brenulevi/GravitumFCS/Hardware/Airplane.pdf

# Gravitum Flight Control - Hardware Components

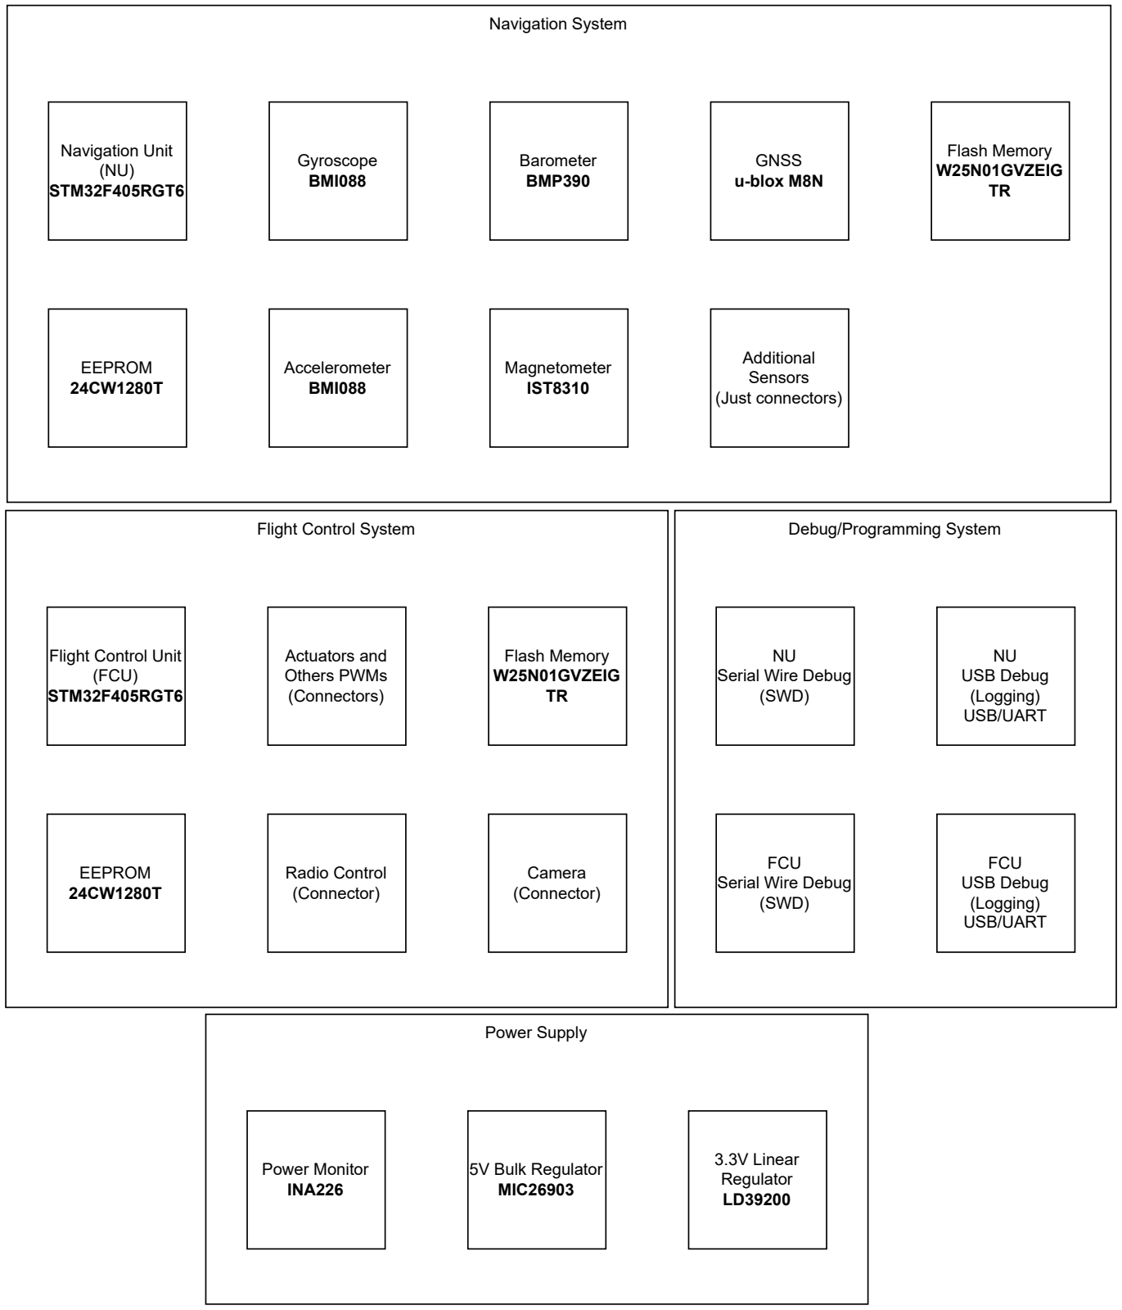
[picture p1: figure]
Power Supply; Power Monitor INA226; 5V Bulk Regulator MIC26903; 3.3V Linear Regulator LD39200; Navigation System; Navigation Unit (NU) STM32F405RGT6; EEPROM 24CW1280T; Gyroscope BMI088; Accelerometer BMI088; Barometer BMP390; Magnetometer IST8310; GNSS u-blox M8N; Additional Sensors (Just connectors); Flash Memory W25N01GVZEIG TR; Flight Control System; Flight Control Unit (FCU) STM32F405RGT6; Actuators and Others PWMs (Connectors); Radio Control (Connector); Camera (Connector); Debug/Programming System; NU Serial Wire Debug (SWD); NU USB Debug (Logging) USB/UART; FCU Serial Wire Debug (SWD); FCU USB Debug (Logging) USB/UART

# Gravitum Flight Control - Protocols

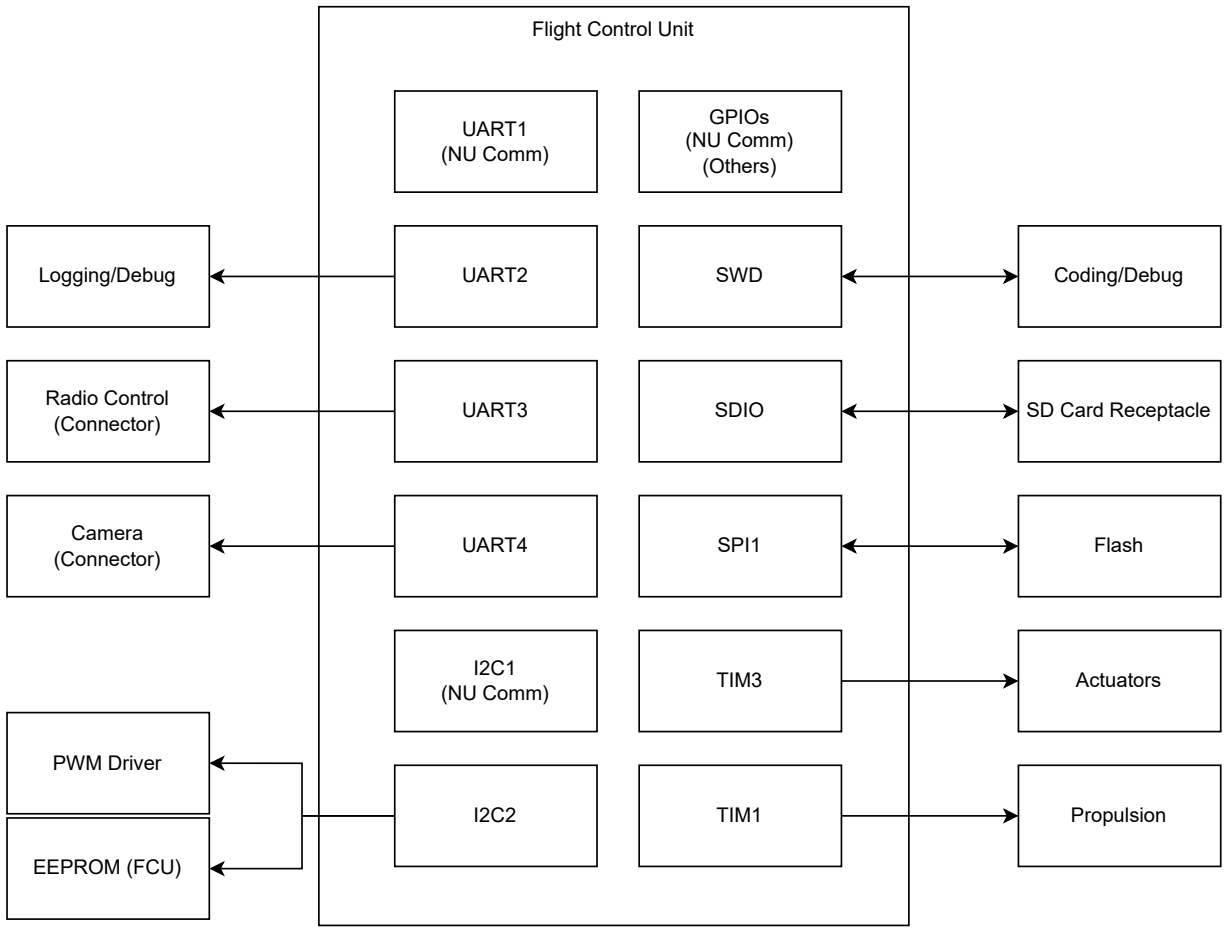
[picture p2: figure]
Flight Control Unit; UART1 (NU Comm); UART2; UART3; UART4; I2C1 (NU Comm); TIM1; TIM3; SPI1; SDIO; SWD; GPIOs (NU Comm) (Others); Logging/Debug; Radio Control (Connector); Camera (Connector); PWM Driver; EEPROM (FCU); Actuators; Propulsion; Flash; SD Card Receptacle; Coding/Debug

# Gravitum Flight Control - Protocols

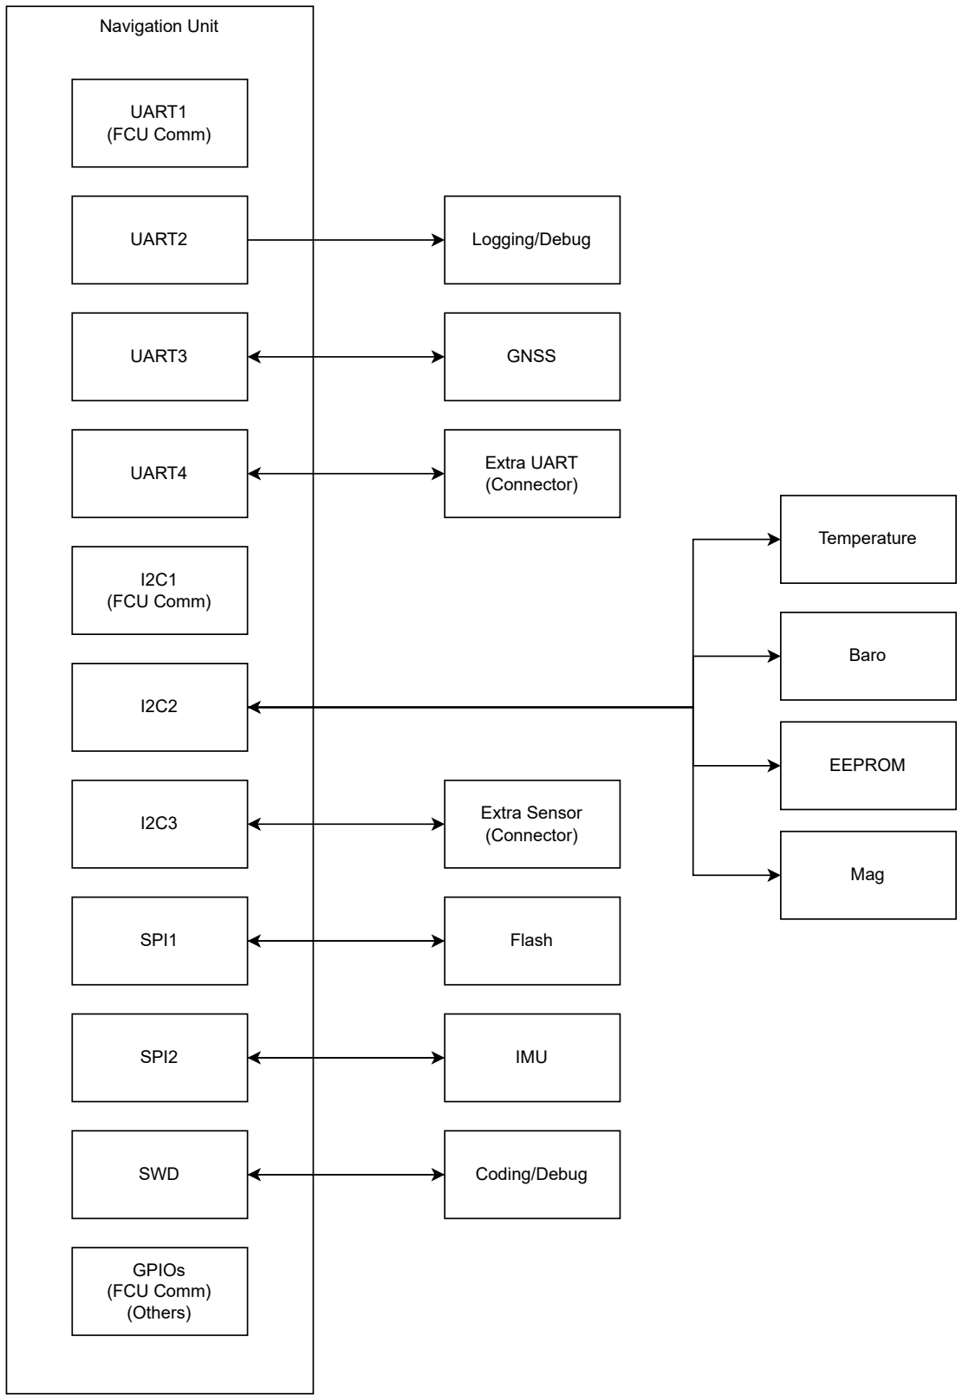
[picture p3: figure]
Navigation Unit; UART1 (FCU Comm); GPIOs (FCU Comm) (Others); UART2; UART3; UART4; I2C1 (FCU Comm); SPI1; SPI2; SWD; Logging/Debug; GNSS; Extra UART (Connector); Temperature; Baro; EEPROM; Mag; Extra Sensor (Connector); Flash; IMU; Coding/Debug
