brenulevi/GravitumFCS/documentation/flight_control_unit_pin_assignment.png

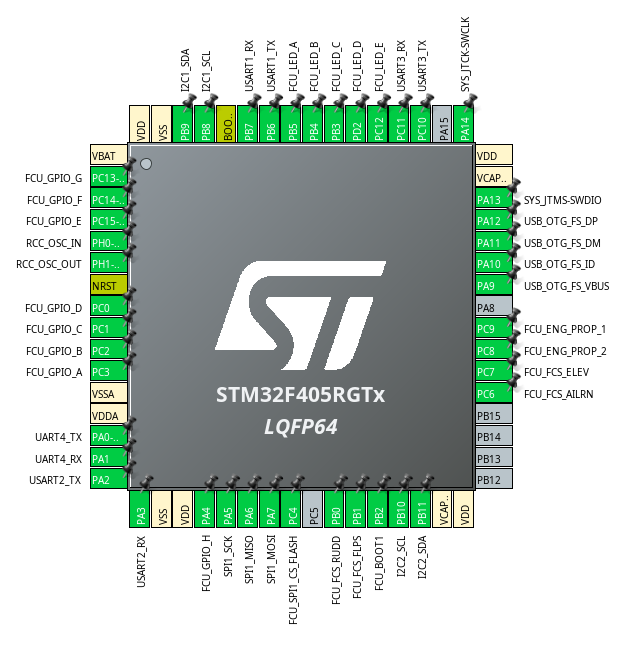
documentation/flight_control_unit_pin_assignment.png
