brenulevi/GravitumFCS/documentation/navigation_unit_pin_assignment.png

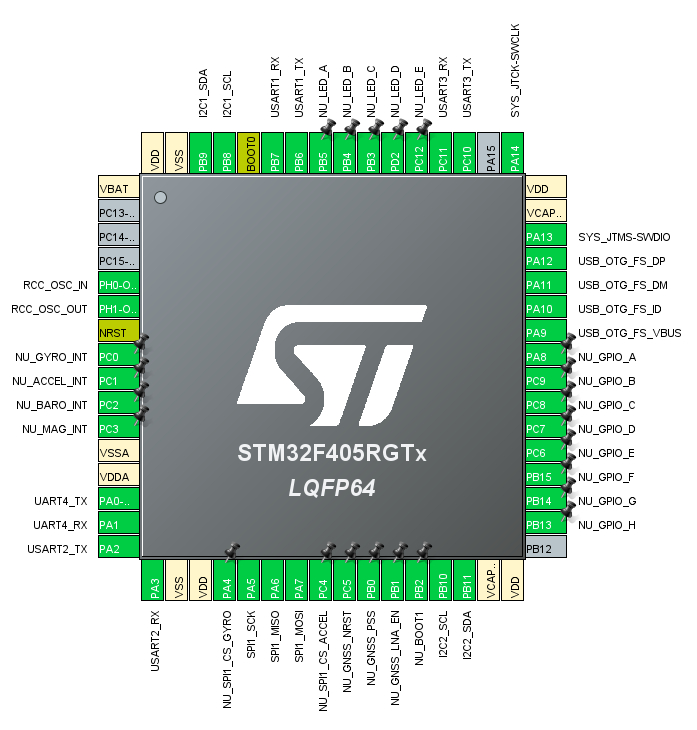
documentation/navigation_unit_pin_assignment.png
