brenulevi/GravitumFCS/hardware/3d_models/SM04B-GHS-TB_LF__SN_-.step

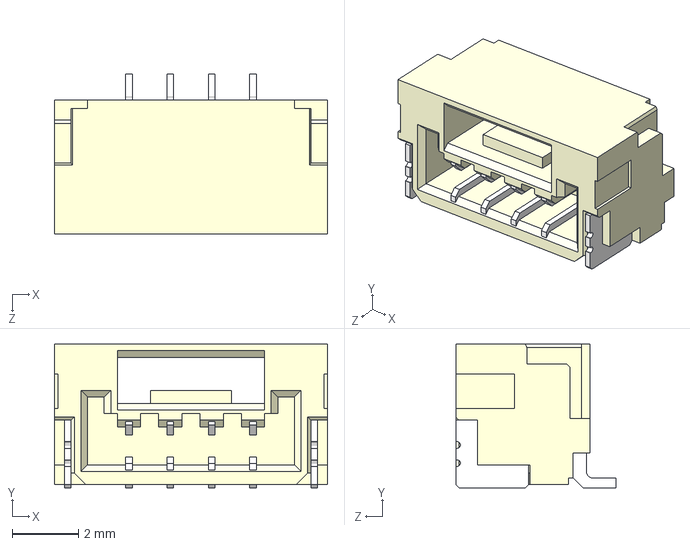
[picture p6: CAD file, 2026-02-11]
hardware/3d_models/SM04B-GHS-TB_LF__SN_-.step
8.25 x 4.35 x 4.85 mm
