brenulevi/GravitumFCS/hardware/3d_models/MPRLS0025PA00001A.step

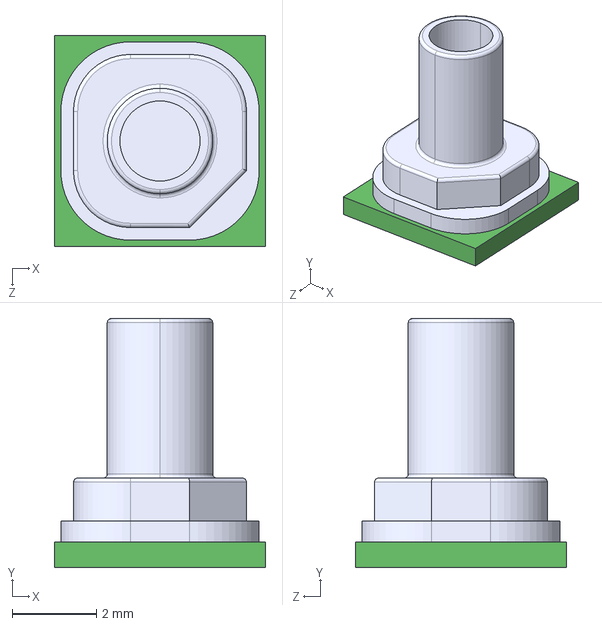
[picture p7: CAD file, 2026-02-11]
hardware/3d_models/MPRLS0025PA00001A.step
5.00 x 5.90 x 5.00 mm
