brenulevi/GravitumFCS/hardware/3d_models/B340A-13-F.STEP

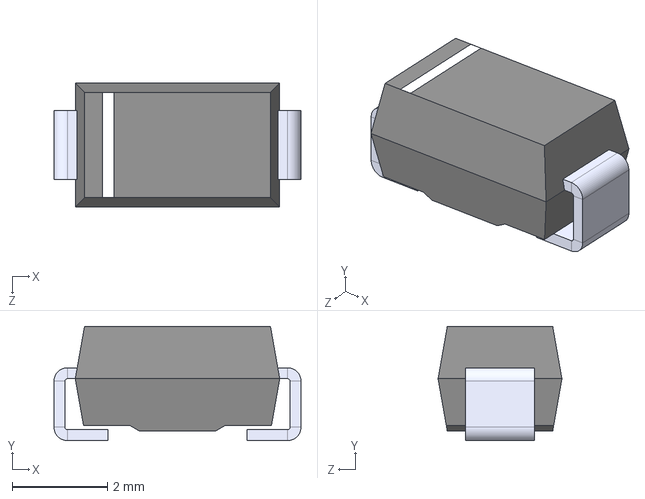
[picture p8: CAD file, 2026-02-11]
hardware/3d_models/B340A-13-F.STEP
5.20 x 2.40 x 2.60 mm
