brenulevi/GravitumFCS/hardware/3d_models/RFPC-SMA28-F.step

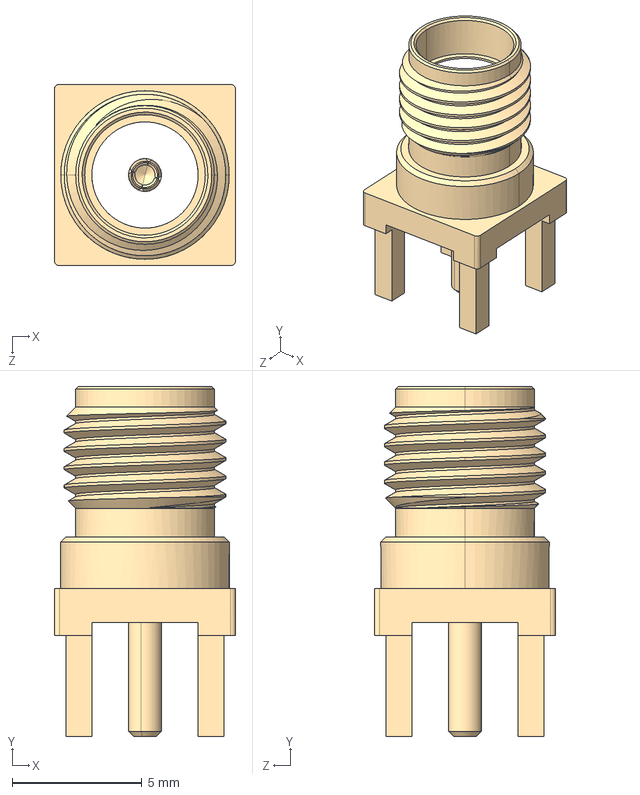
[picture p9: CAD file, 2026-02-11]
hardware/3d_models/RFPC-SMA28-F.step
7.00 x 13.5 x 7.00 mm
HSG
SMA28 JACK Pin_默认
