brenulevi/GravitumFCS/hardware/3d_models/B10B-PHDSS--3DModel-STEP-56544.STEP

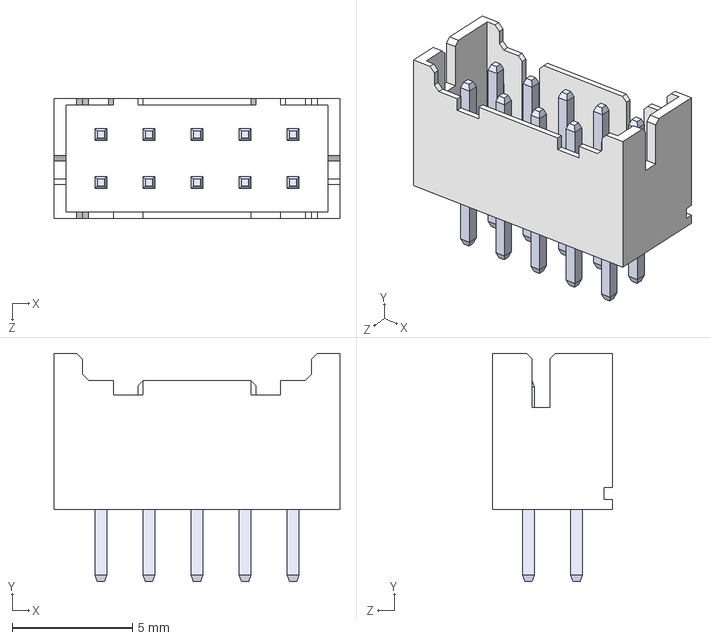
[picture p10: CAD file, 2026-02-11]
hardware/3d_models/B10B-PHDSS--3DModel-STEP-56544.STEP
11.9 x 9.50 x 5.00 mm
BxB-PHDSS_10
pin^BxB-PHDSS ass x 10
