brenulevi/GravitumFCS/hardware/3d_models/TL3365AF180QG.step

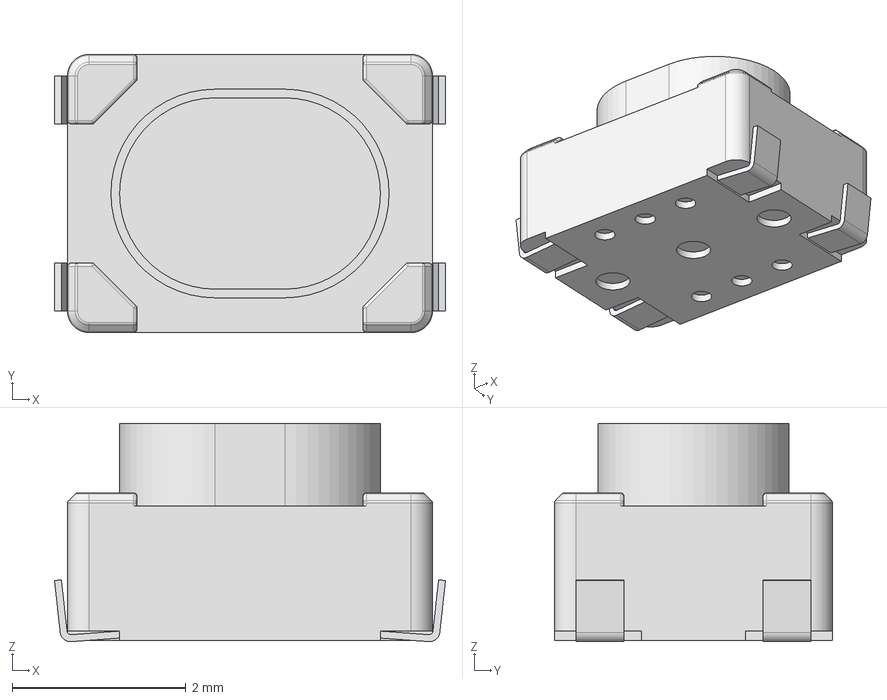
[picture p11: CAD file, 2026-02-11]
hardware/3d_models/TL3365AF180QG.step
4.50 x 3.20 x 2.51 mm
