brenulevi/GravitumFCS/hardware/3d_models/SD103AWS-E3-08.step

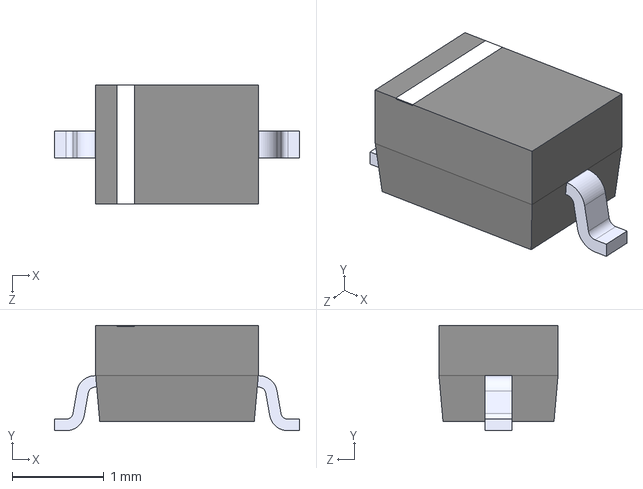
[picture p12: CAD file, 2026-02-11]
hardware/3d_models/SD103AWS-E3-08.step
2.67 x 1.15 x 1.30 mm
