brenulevi/GravitumFCS/hardware/3d_models/ABM8G-25.000MHZ-18-D2Y-T.step

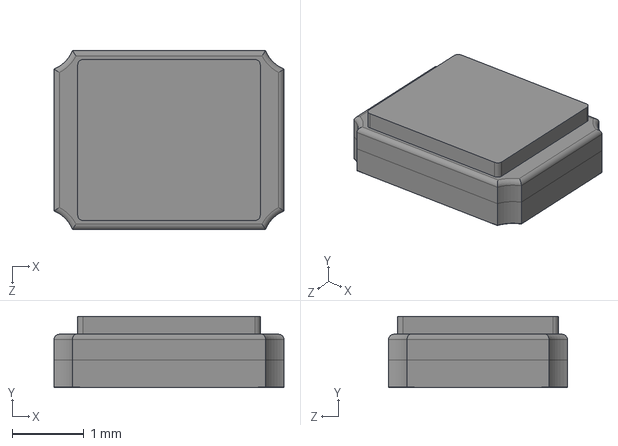
[picture p13: CAD file, 2026-02-11]
hardware/3d_models/ABM8G-25.000MHZ-18-D2Y-T.step
3.20 x 0.991 x 2.49 mm
