brenulevi/GravitumFCS/hardware/3d_models/LGA-12_2X2X0P7_STM.step

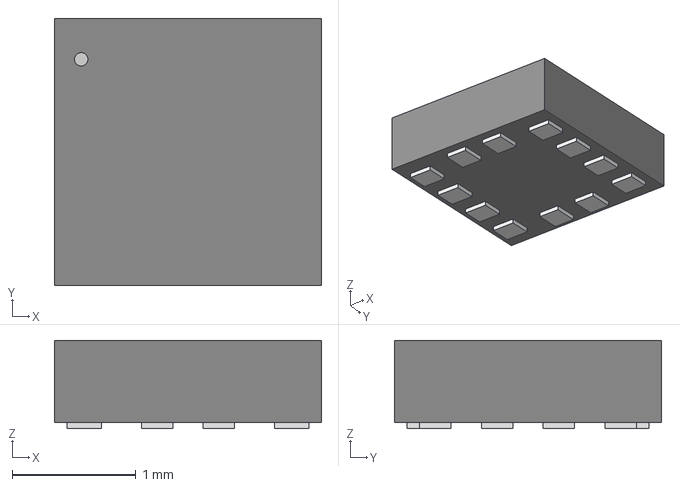
[picture p14: CAD file, 2026-02-11]
hardware/3d_models/LGA-12_2X2X0P7_STM.step
2.16 x 2.16 x 0.714 mm
