brenulevi/GravitumFCS/hardware/3d_models/AT45DB641E-SHN2B-T.step

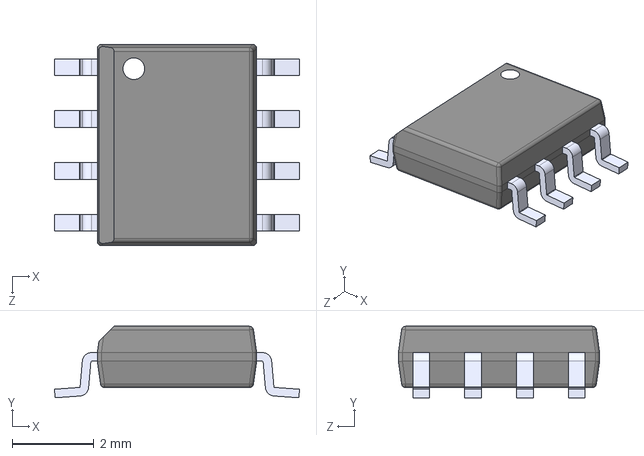
[picture p15: CAD file, 2026-02-11]
hardware/3d_models/AT45DB641E-SHN2B-T.step
6.00 x 1.75 x 4.93 mm
