brenulevi/GravitumFCS/Hardware/3D_Models/IND_SRP1038A_BRN.step

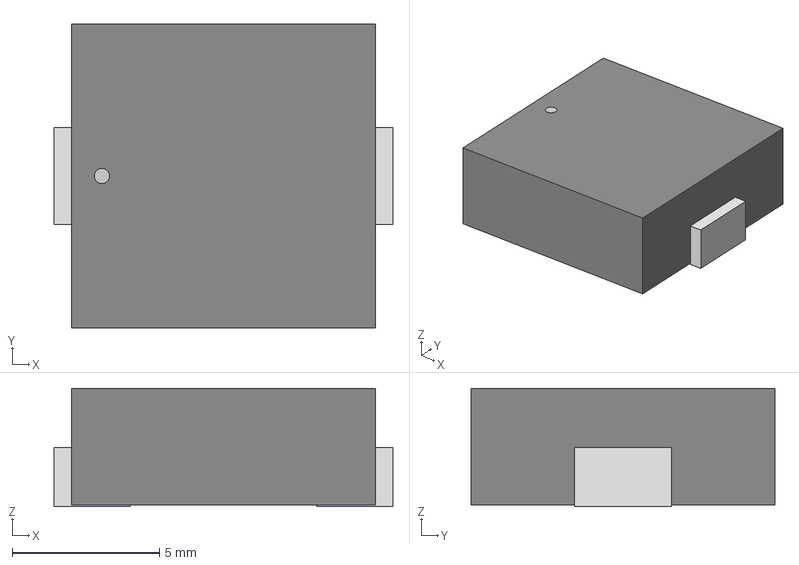
[picture p16: CAD file, 2026-01-27]
Hardware/3D_Models/IND_SRP1038A_BRN.step
11.5 x 10.3 x 4.02 mm
