brenulevi/GravitumFCS/Hardware/3D_Models/5-1814832-1.step

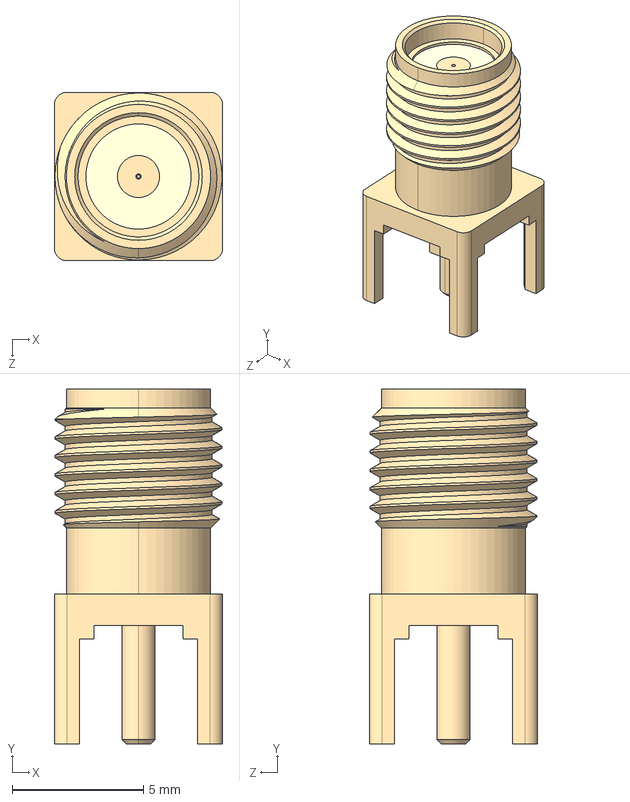
[picture p17: CAD file, 2026-01-15]
Hardware/3D_Models/5-1814832-1.step
6.40 x 13.5 x 6.40 mm
