brenulevi/GravitumFCS/Hardware/3D_Models/DBV0006A.stp

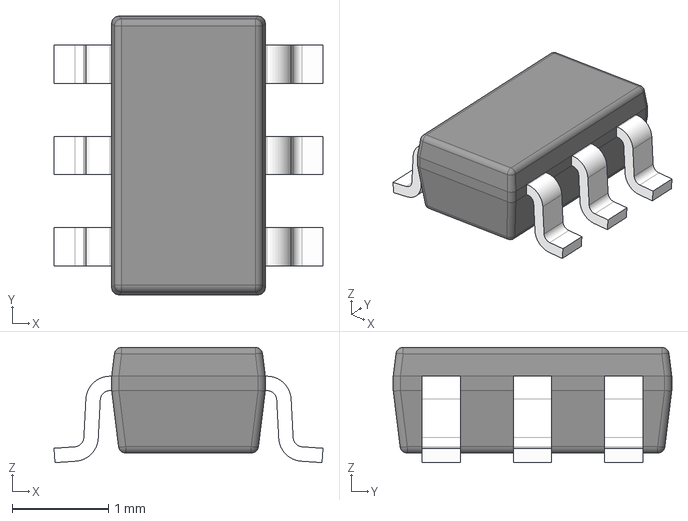
[picture p18: CAD file, 2026-01-15]
Hardware/3D_Models/DBV0006A.stp
2.80 x 2.90 x 1.20 mm
BODY-SOT
LEAD-SOT x 6
