brenulevi/GravitumFCS/Hardware/3D_Models/SON_DFN6_3X3_STM.step

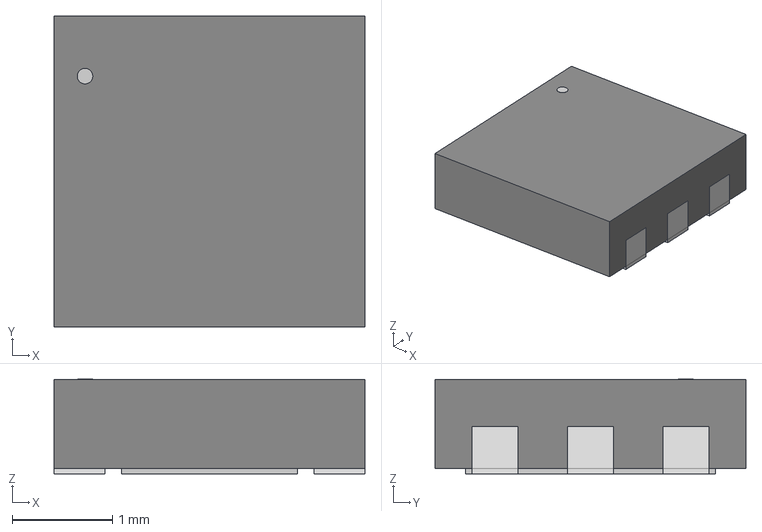
[picture p19: CAD file, 2026-01-15]
Hardware/3D_Models/SON_DFN6_3X3_STM.step
3.10 x 3.10 x 0.942 mm
