brenulevi/GravitumFCS/Hardware/3D_Models/IST8310.step

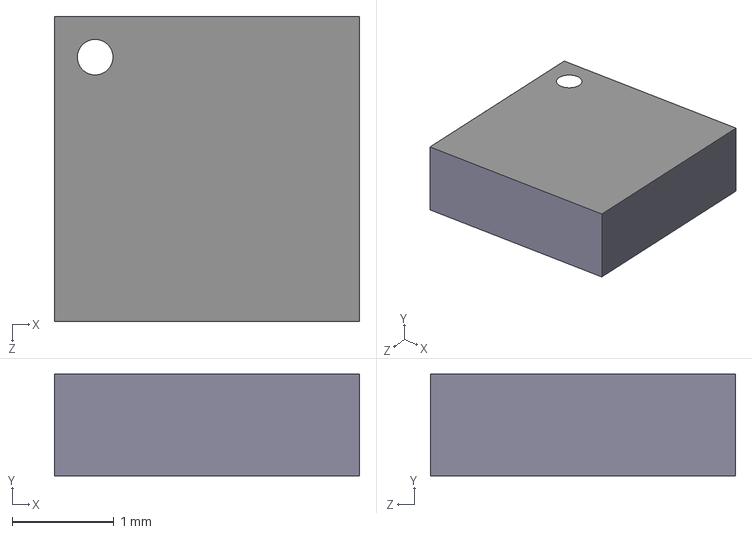
[picture p21: CAD file, 2026-01-15]
Hardware/3D_Models/IST8310.step
3.00 x 1.00 x 3.00 mm
