brenulevi/GravitumFCS/Hardware/3D_Models/BMI088.step

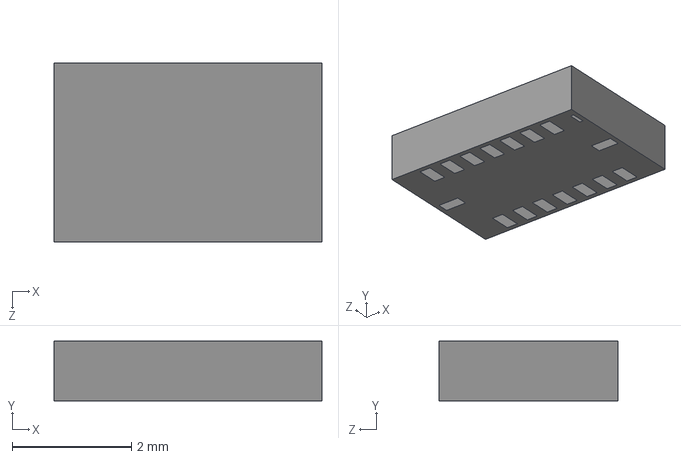
[picture p22: CAD file, 2026-01-15]
Hardware/3D_Models/BMI088.step
4.50 x 1.00 x 3.00 mm
