brenulevi/GravitumFCS/Hardware/3D_Models/DGS0010A.stp

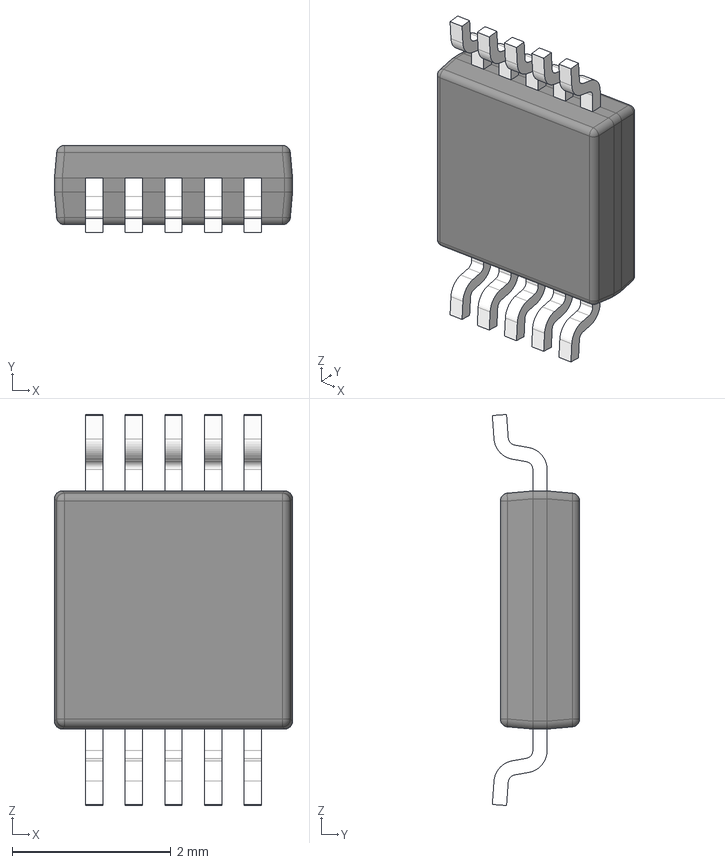
[picture p23: CAD file, 2026-01-15]
Hardware/3D_Models/DGS0010A.stp
3.00 x 1.10 x 4.93 mm
BODY-SO
LEAD-SO x 10
PIN1-ID
