brenulevi/GravitumFCS/Hardware/3D_Models/NEO-M8N-0.STEP

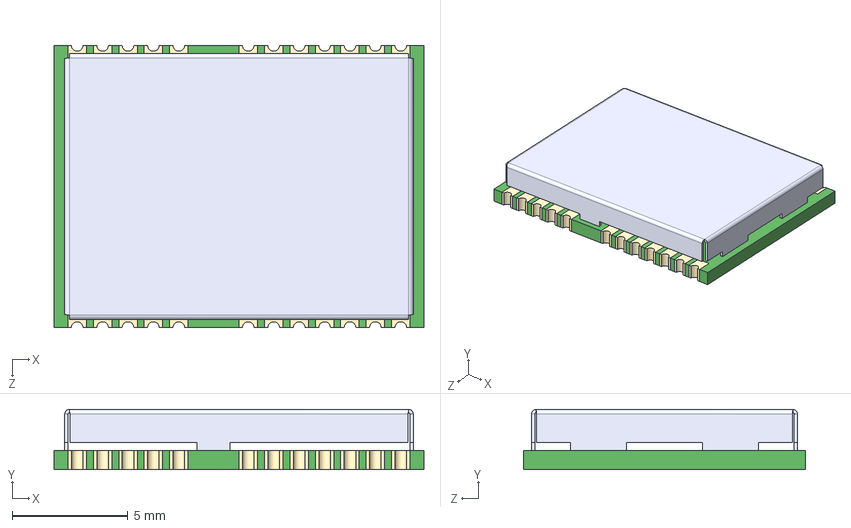
[picture p24: CAD file, 2026-01-15]
Hardware/3D_Models/NEO-M8N-0.STEP
16.0 x 2.60 x 12.2 mm
