brenulevi/GravitumFCS/Hardware/3D_Models/SOT-23-5_2P9X1P6_MCH.step

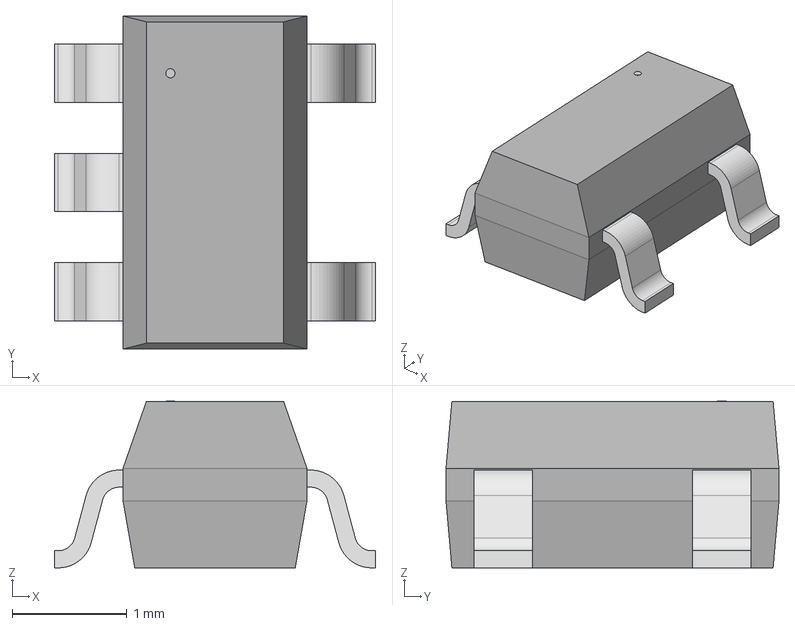
[picture p25: CAD file, 2026-01-15]
Hardware/3D_Models/SOT-23-5_2P9X1P6_MCH.step
2.79 x 2.90 x 1.45 mm
