brenulevi/GravitumFCS/Hardware/3D_Models/STM32F405RGT6.step

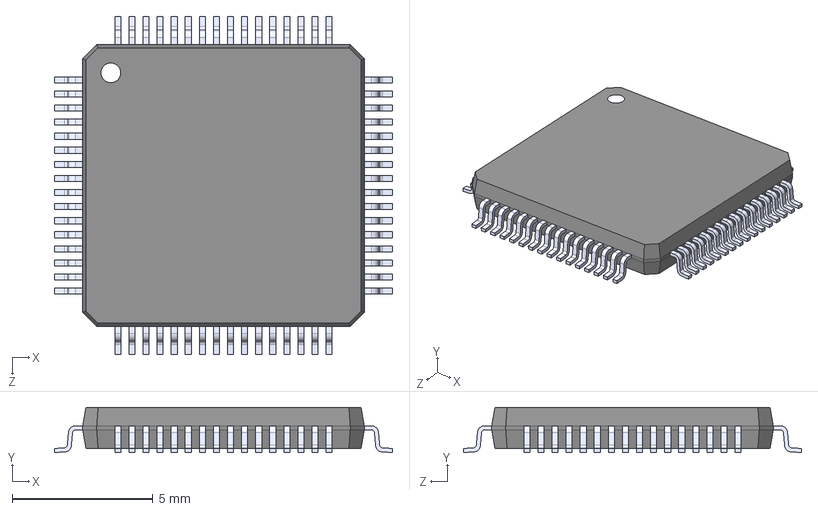
[picture p26: CAD file, 2026-01-15]
Hardware/3D_Models/STM32F405RGT6.step
12.0 x 1.60 x 12.0 mm
