brenulevi/GravitumFCS/Hardware/3D_Models/TSSOP28__SOT361-1__NXP.step

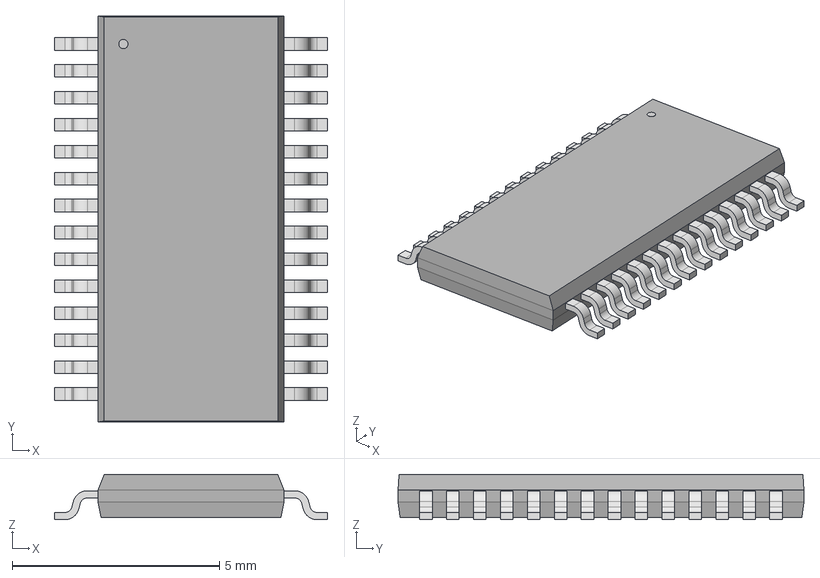
[picture p27: CAD file, 2026-01-15]
Hardware/3D_Models/TSSOP28__SOT361-1__NXP.step
6.60 x 9.80 x 1.09 mm
