brenulevi/GravitumFCS/Hardware/3D_Models/W25N01GVZEIG_TR.step

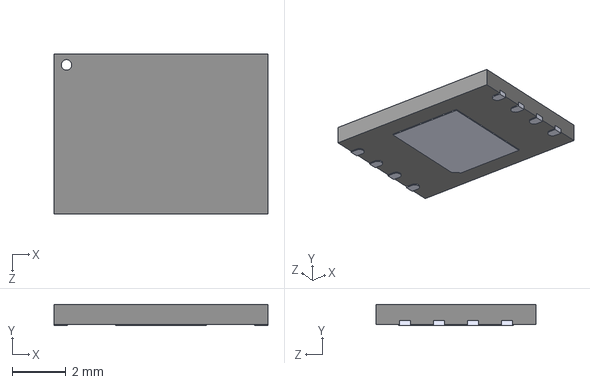
[picture p28: CAD file, 2026-01-15]
Hardware/3D_Models/W25N01GVZEIG_TR.step
8.00 x 0.8 x 6.00 mm
