brenulevi/GravitumFCS/(list of files, cad)

Other CAD files:
Hardware/3D_Models/MIC26903YJL-TR.step
hardware/3d_models/LD39200PU33R.step
