brenulevi/GravitumFCS/hardware/gravitumfcs.pdf

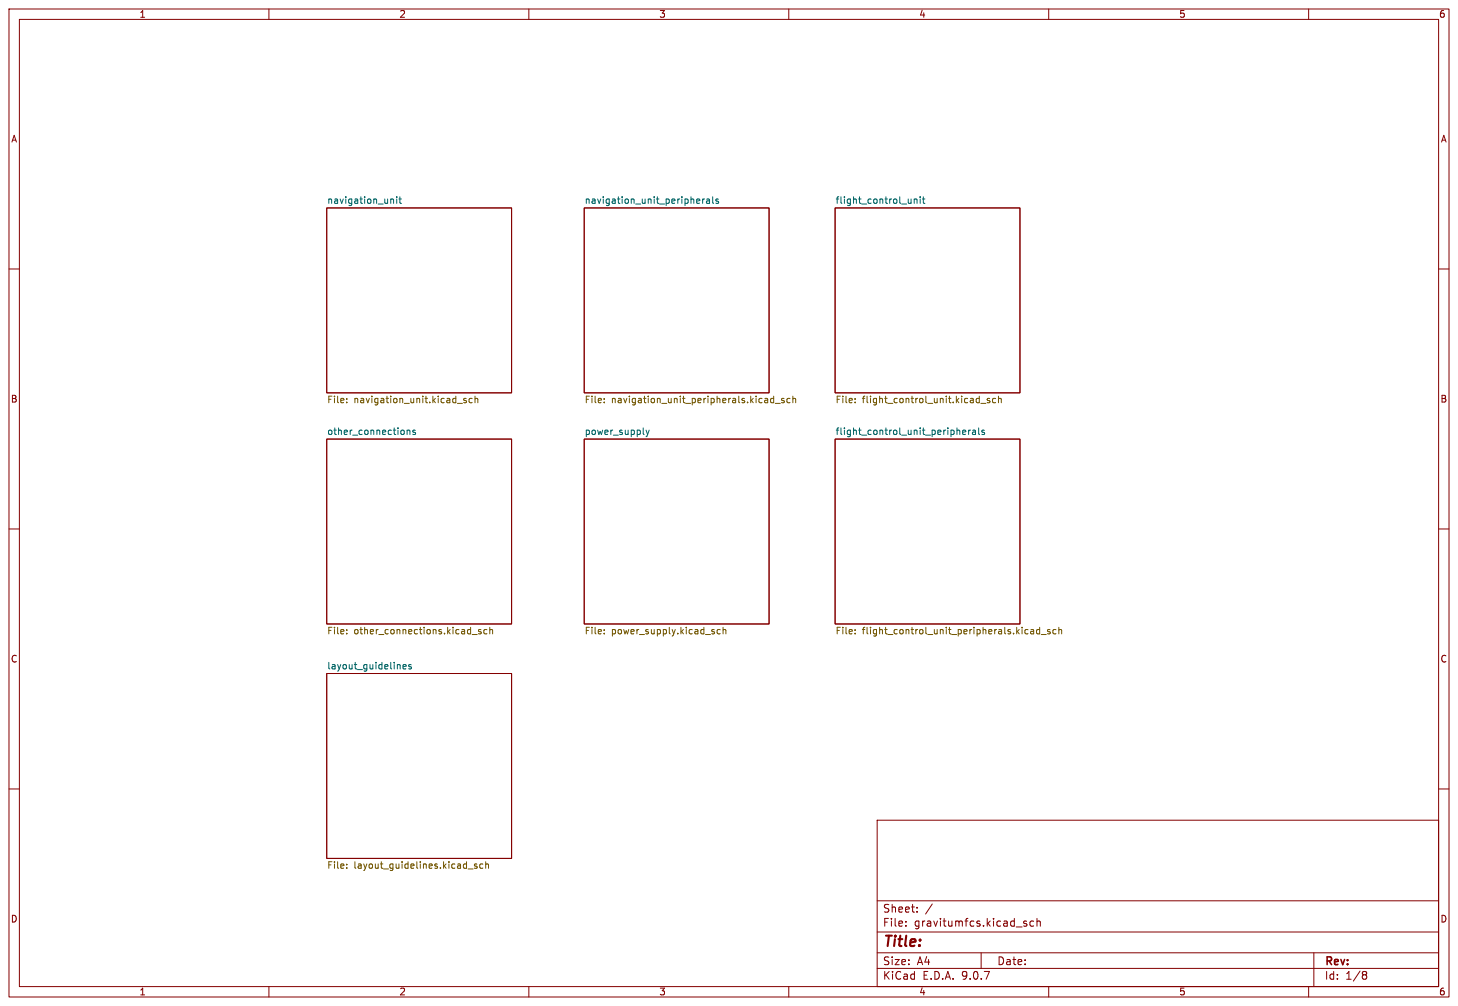
[picture p29: page 1]

Id: 1/8 Title: File: gravitumfcs.kicad_sch Sheet: /

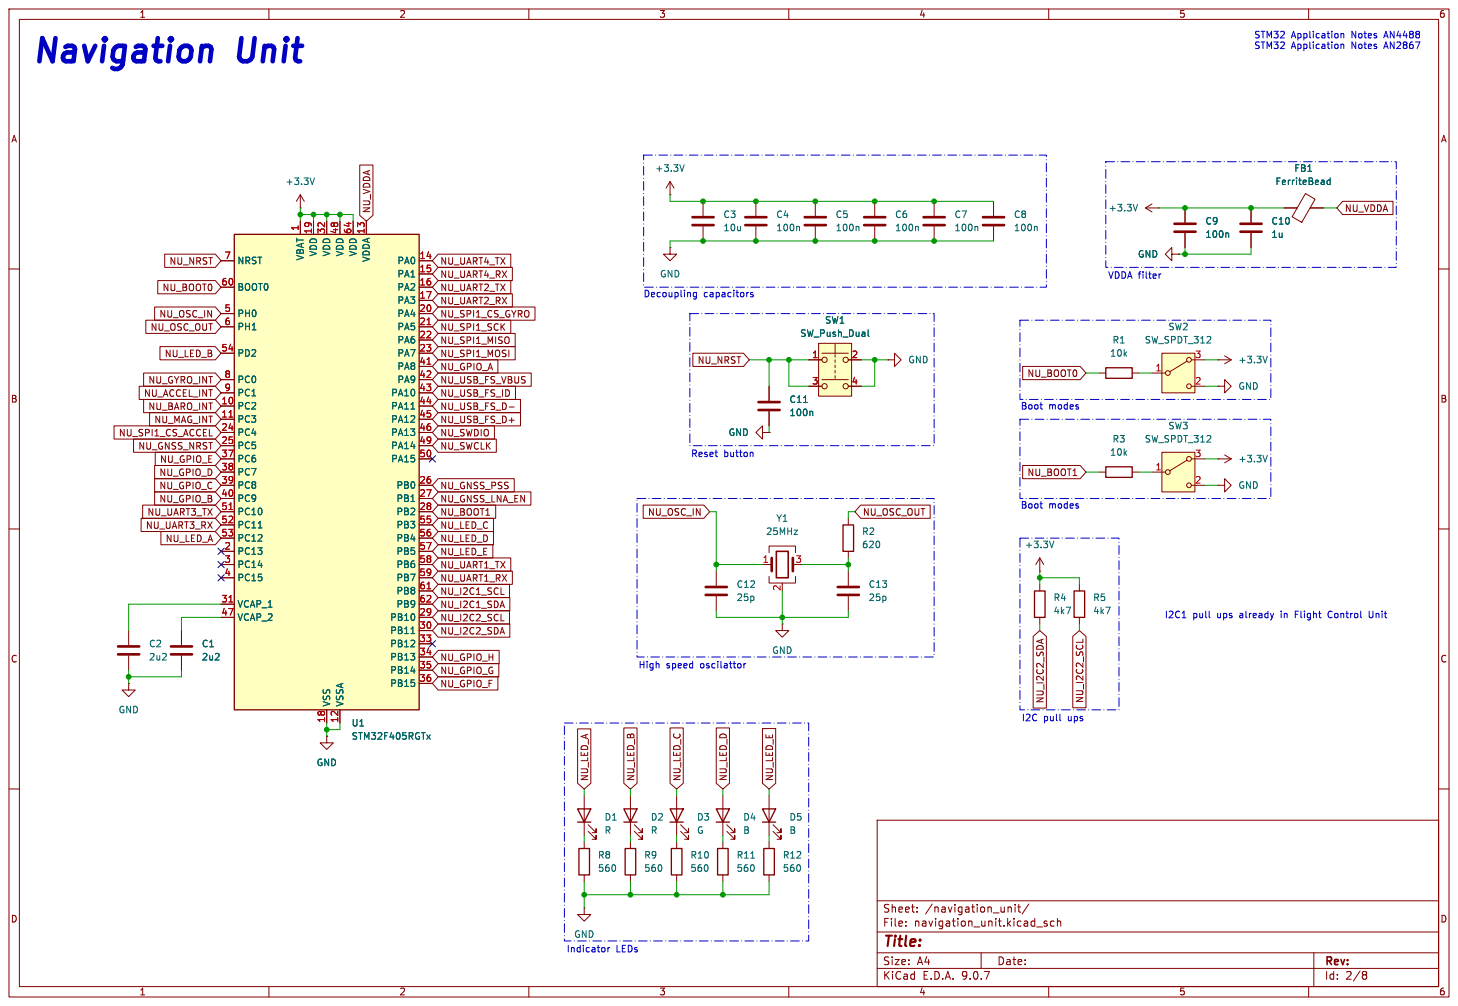
[picture p30: page 2]

I2C pull ups Navigation Unit

1 VDD 19 VDD 32 VSS 18 VDD 48 VSSA 12 VDD 64 VDDA 13 PA0 14 PA1 15 PA2 16 PA3 17 PA4 20 PA5 21 PA6 22 PA7 23 PA8 41 PA9 42 PA10 43 PA11 44 PA12 45 PA13 46 PA14 49 PA15 50 PB0 26 PB1 27 PB2 28 PB3 55 PB4 56 PB5 57 PB6 58 PB7 59 PB8 61 PB9 62 PB10 29 PB11 30 PB12 33 PB13 34 PB14 35 PB15 36 U1STM32F405RGTx C1

1 VDD 19 VDD 32 VSS 18 VDD 48 VSSA 12 VDD 64 VDDA 13 PA0 14 PA1 15 PA2 16 PA3 17 PA4 20 PA5 21 PA6 22 PA7 23 PA8 41 PA9 42 PA10 43 PA11 44 PA12 45 PA13 46 PA14 49 PA15 50 PB0 26 PB1 27 PB2 28 PB3 55 PB4 56 PB5 57 PB6 58 PB7 59 PB8 61 PB9 62 PB10 29 PB11 30 PB12 33 PB13 34 PB14 35 PB15 36 C1

VDDA filter Boot modes

Id: 2/8 Title: File: navigation_unit.kicad_sch Sheet: /navigation_unit/

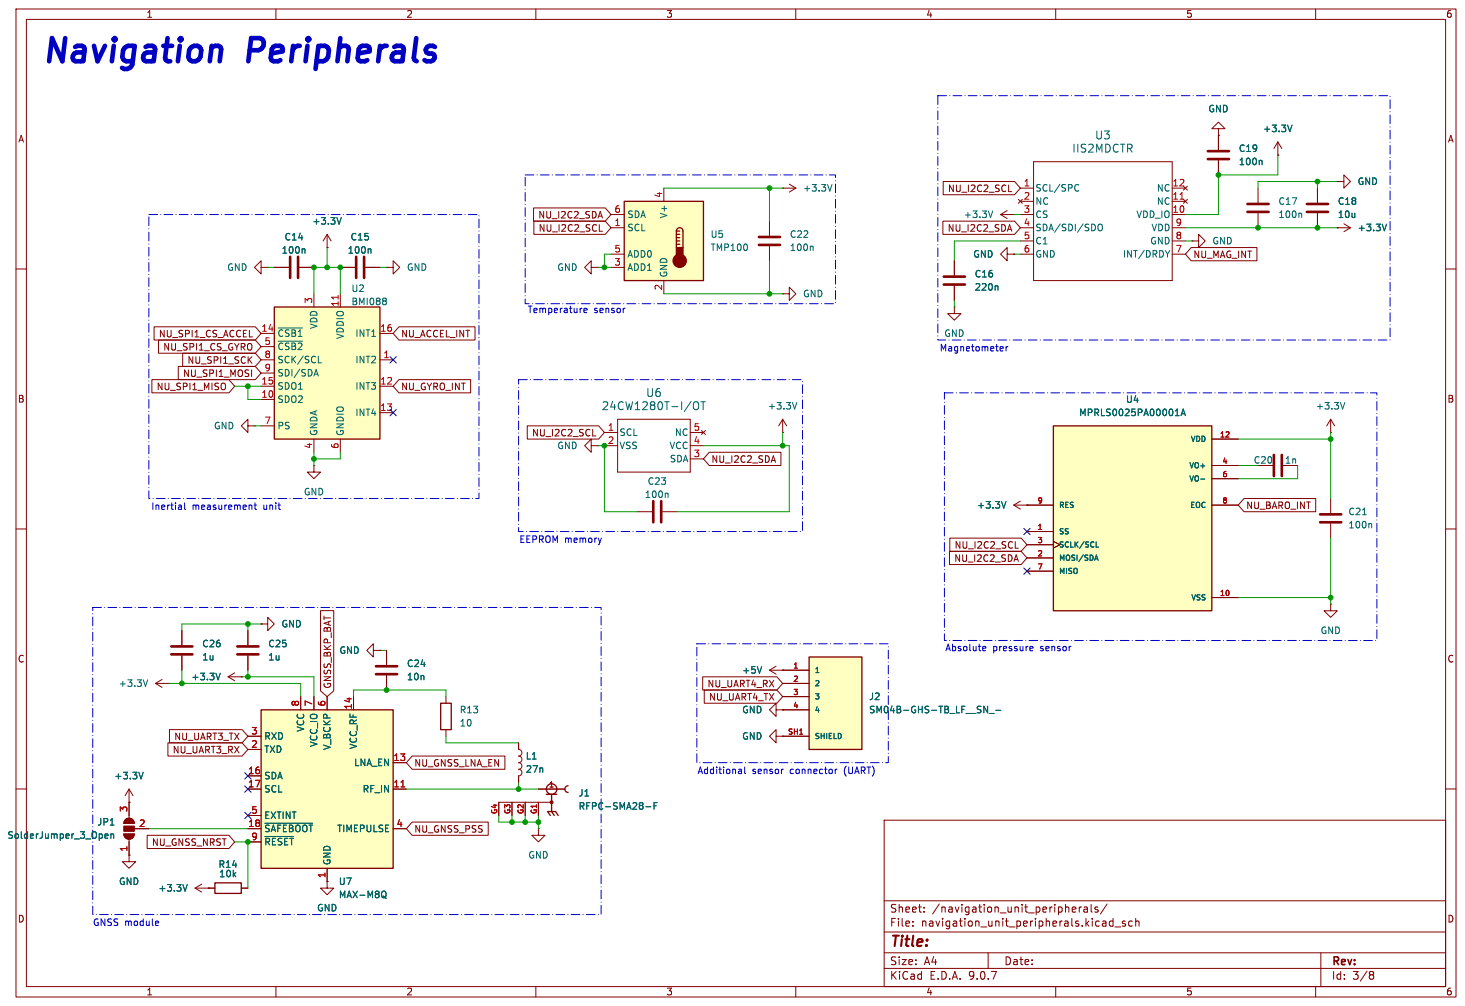
[picture p31: page 3]

IIS2MDCTR
Magnetometer Absolute pressure sensor

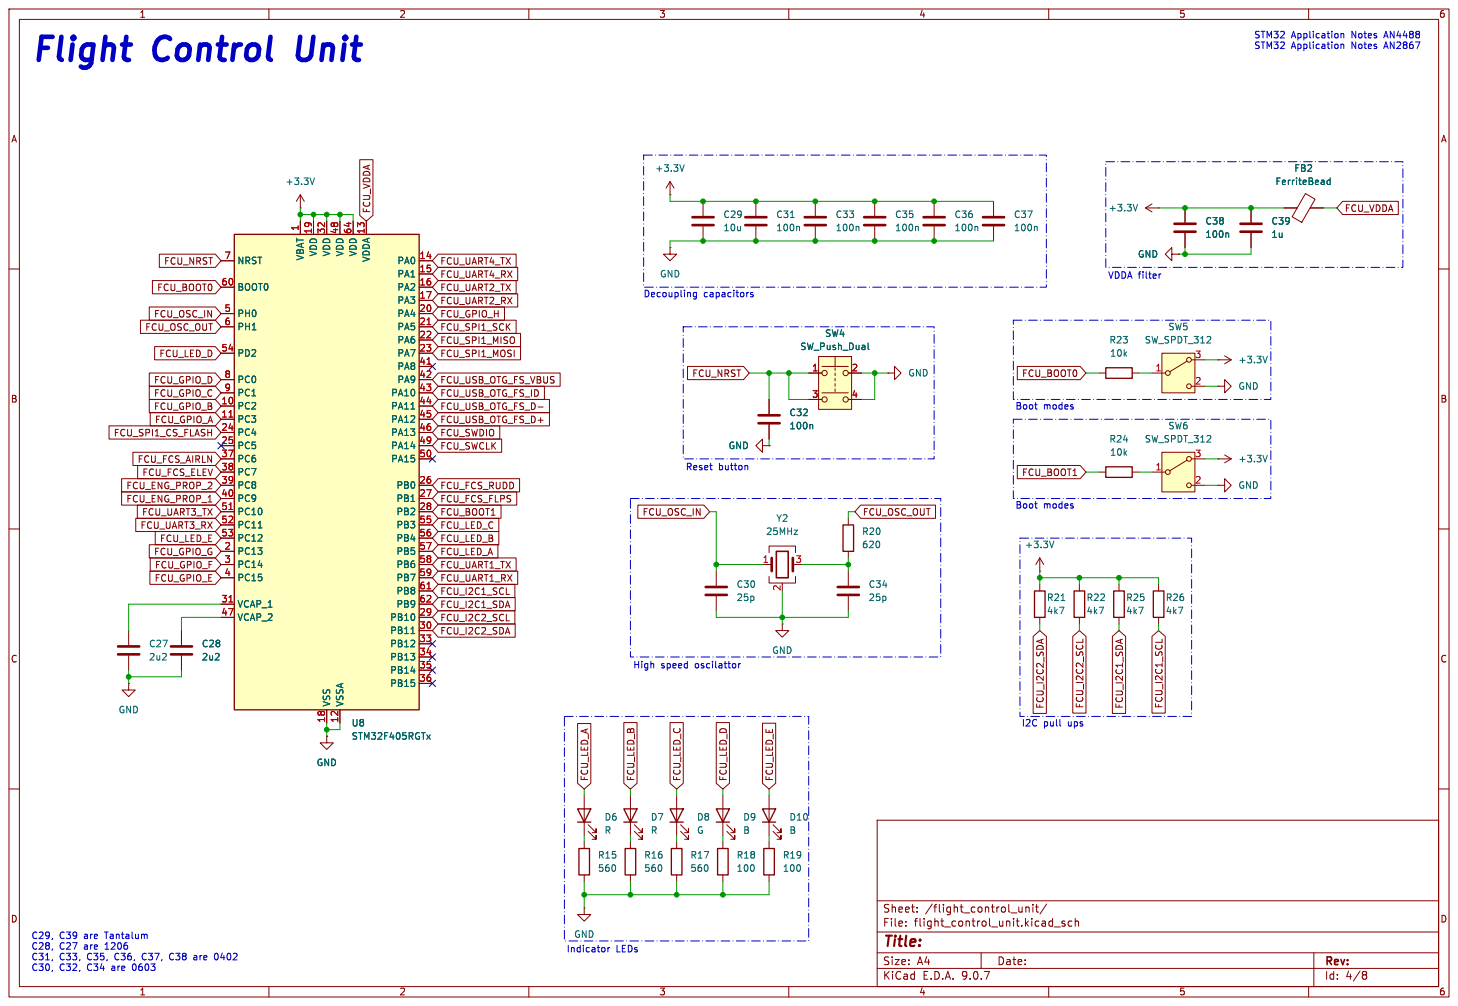
[picture p32: page 4]

1 VDD 19 VDD 32 VSS 18 VDD 48 VSSA 12 VDD 64 VDDA 13 PA0 14 PA1 15 PA2 16 PA3 17 PA4 20 PA5 21 PA6 22 PA7 23 PA8 41 PA9 42 PA10 43 PA11 44 PA12 45 PA13 46 PA14 49 PA15 50 PB0 26 PB1 27 PB2 28 PB3 55 PB4 56 PB5 57 PB6 58 PB7 59 PB8 61 PB9 62 PB10 29 PB11 30 PB12 33 PB13 34 PB14 35 PB15 36 U8STM32F405RGTx C30

1 VDD 19 VDD 32 VSS 18 VDD 48 VSSA 12 VDD 64 VDDA 13 PA0 14 PA1 15 PA2 16 PA3 17 PA4 20 PA5 21 PA6 22 PA7 23 PA8 41 PA9 42 PA10 43 PA11 44 PA12 45 PA13 46 PA14 49 PA15 50 PB0 26 PB1 27 PB2 28 PB3 55 PB4 56 PB5 57 PB6 58 PB7 59 PB8 61 PB9 62 PB10 29 PB11 30 PB12 33 PB13 34 PB14 35 PB15 36 GND

Id: 4/8 Title: File: flight_control_unit.kicad_sch Sheet: /flight_control_unit/ GND

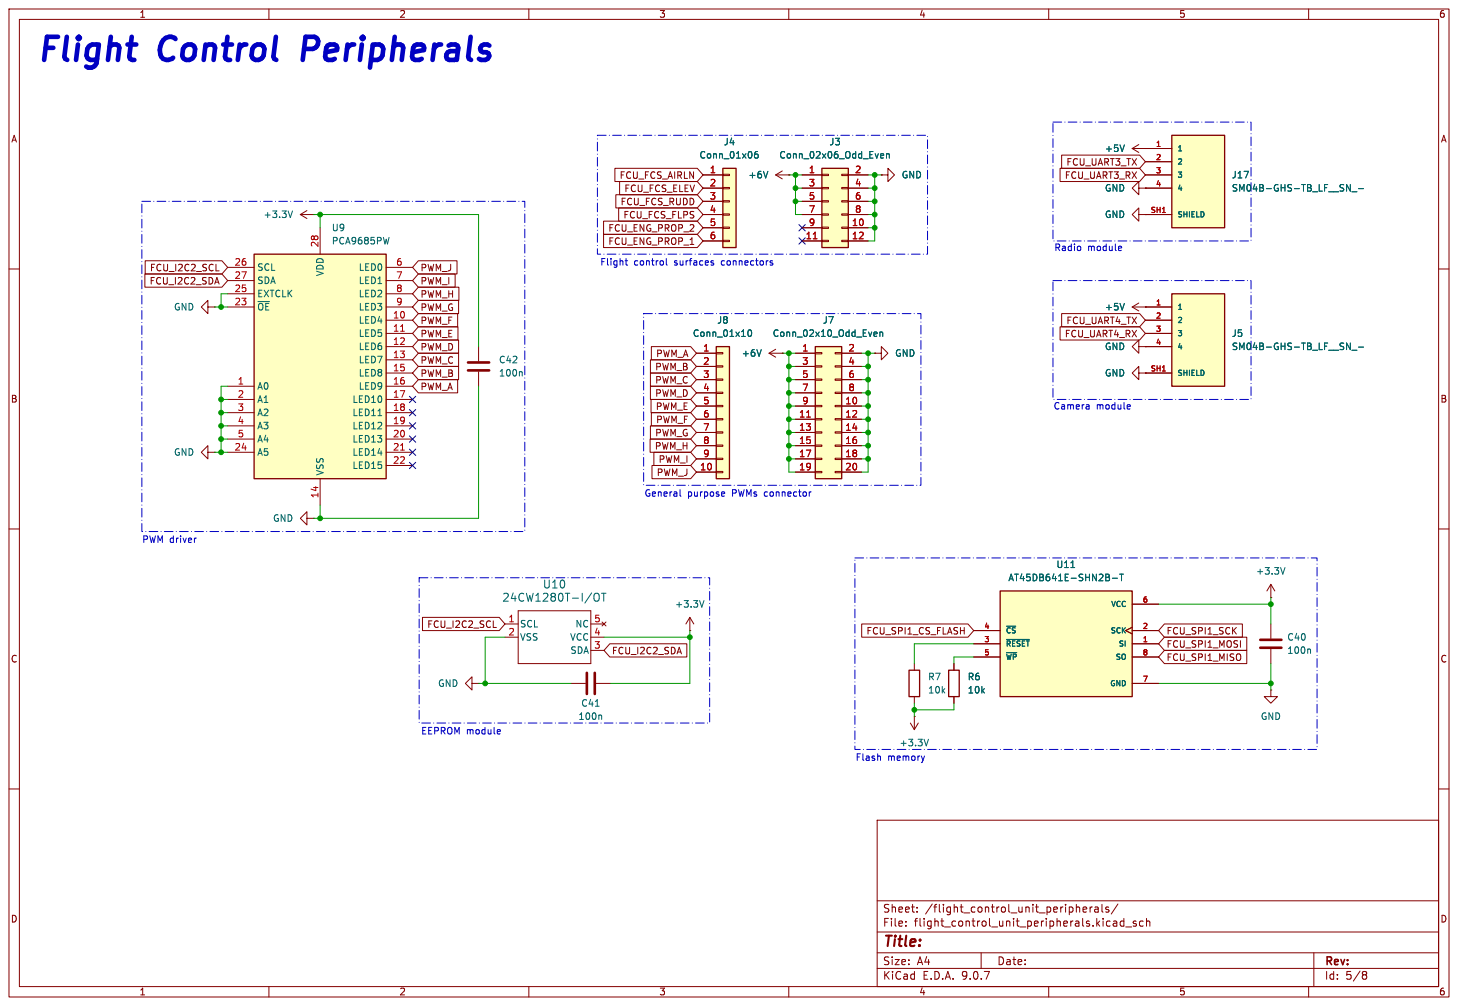
[picture p33: page 5]

Id: 5/8 Title: File: flight_control_unit_peripherals.kicad_sch Sheet: /flight_control_unit_peripherals/ R7

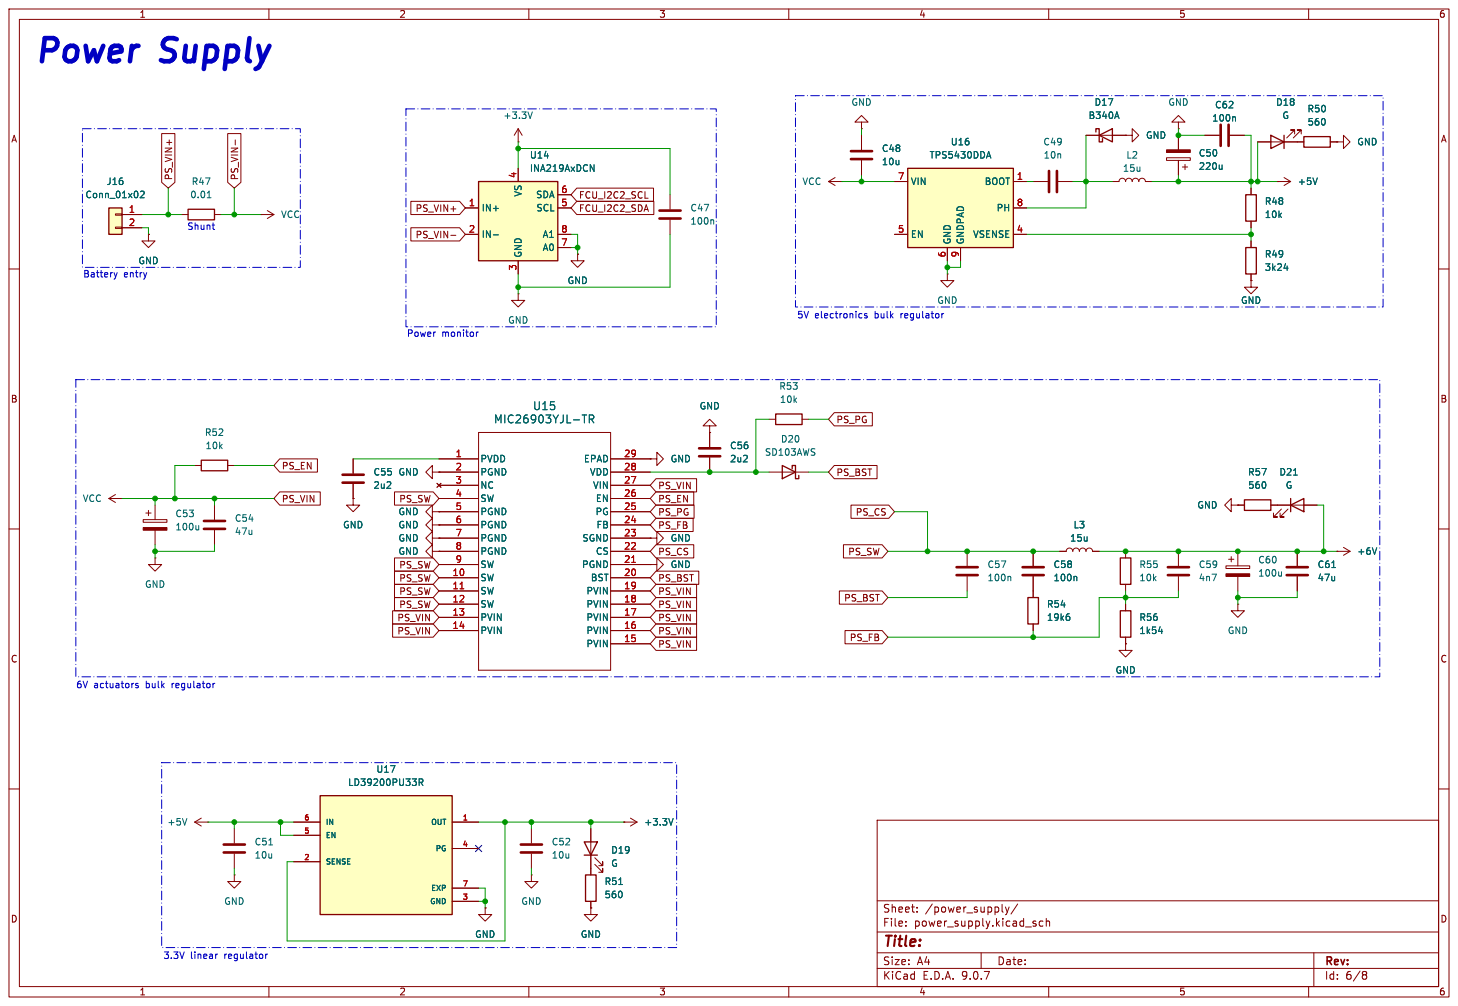
[picture p34: page 6]

9 BOOT 1 PH 8 VSENSE 4 U16 TPS5430DDA GND GND

Id: 6/8 Title: File: power_supply.kicad_sch Sheet: /power_supply/ +5V

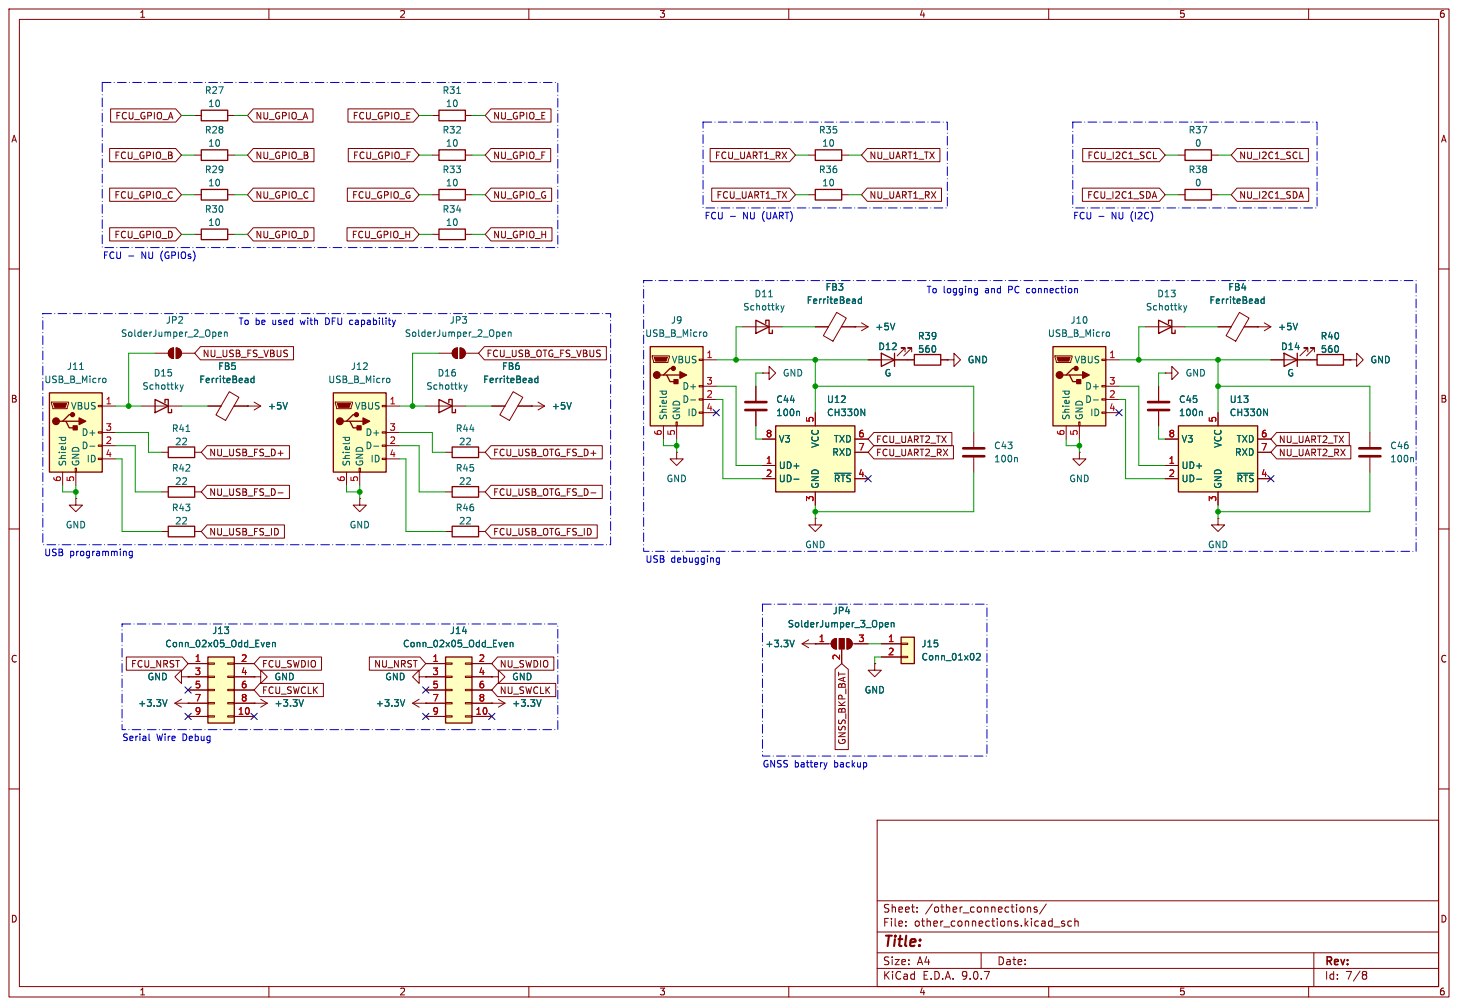
[picture p35: page 7]

3 TXD 6 RXD 7 ~{RTS}4 GND

3 TXD 6 RXD 7 ~{RTS}4 U12 CH330N GND

3 TXD 6 RXD 7 ~{RTS}4 U13 CH330N GND

Id: 7/8 Title: File: other_connections.kicad_sch Sheet: /other_connections/

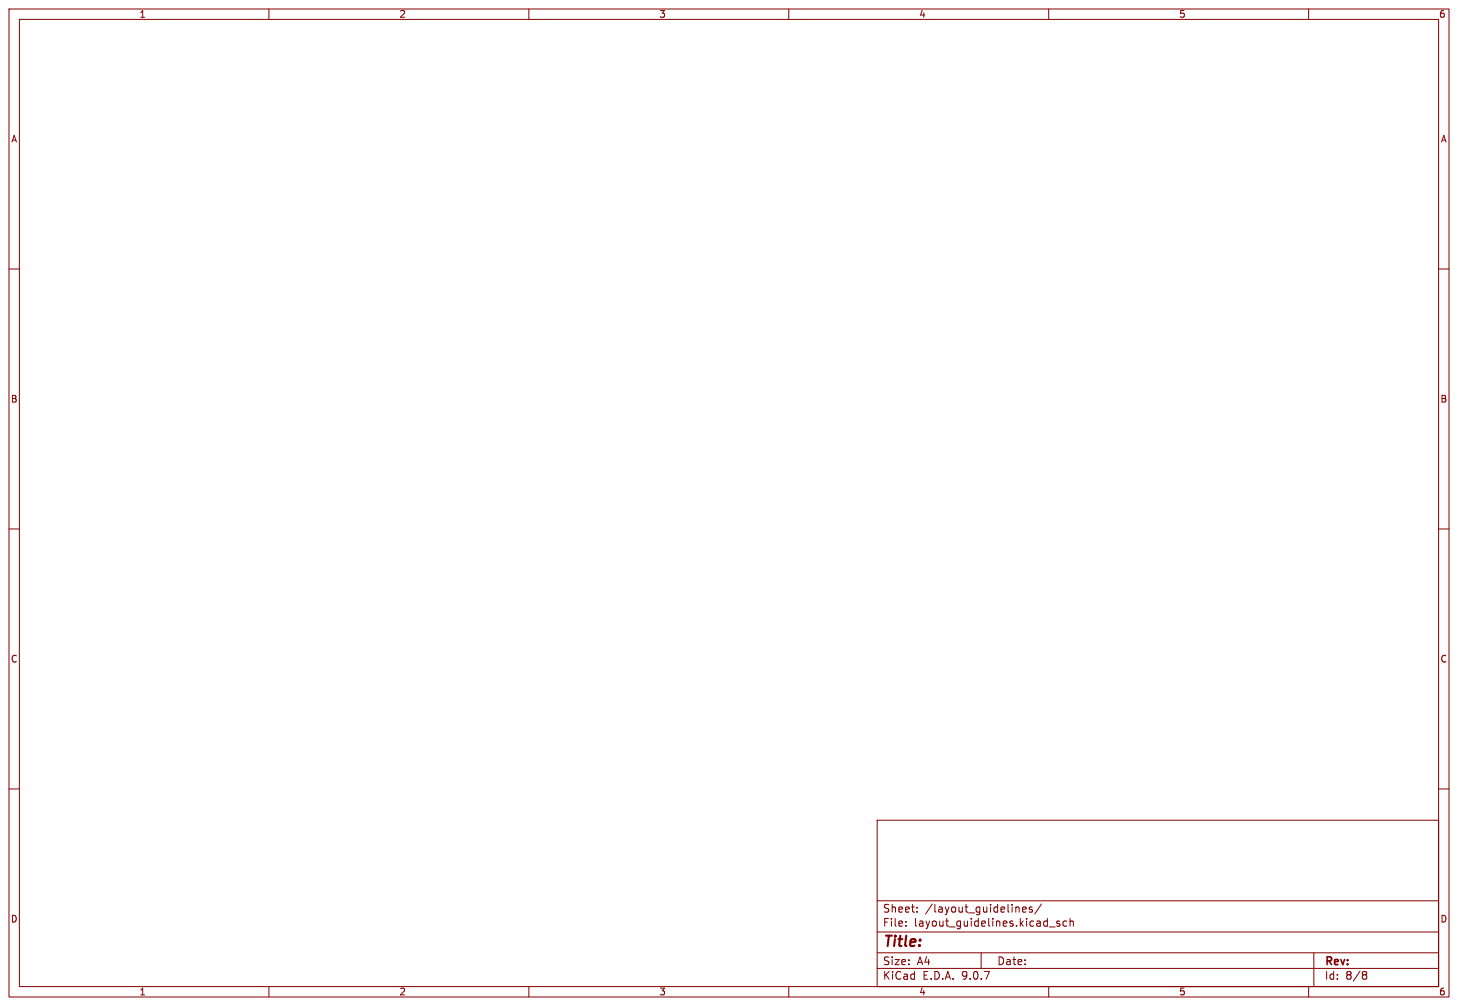
[picture p36: page 8]

Id: 8/8 Title: File: layout_guidelines.kicad_sch Sheet: /layout_guidelines/
