brenulevi/GravitumFCS/hardware/gravitumfcs.kicad_pcb

## KiCad design hardware/gravitumfcs.kicad_pcb (2026-02-11)

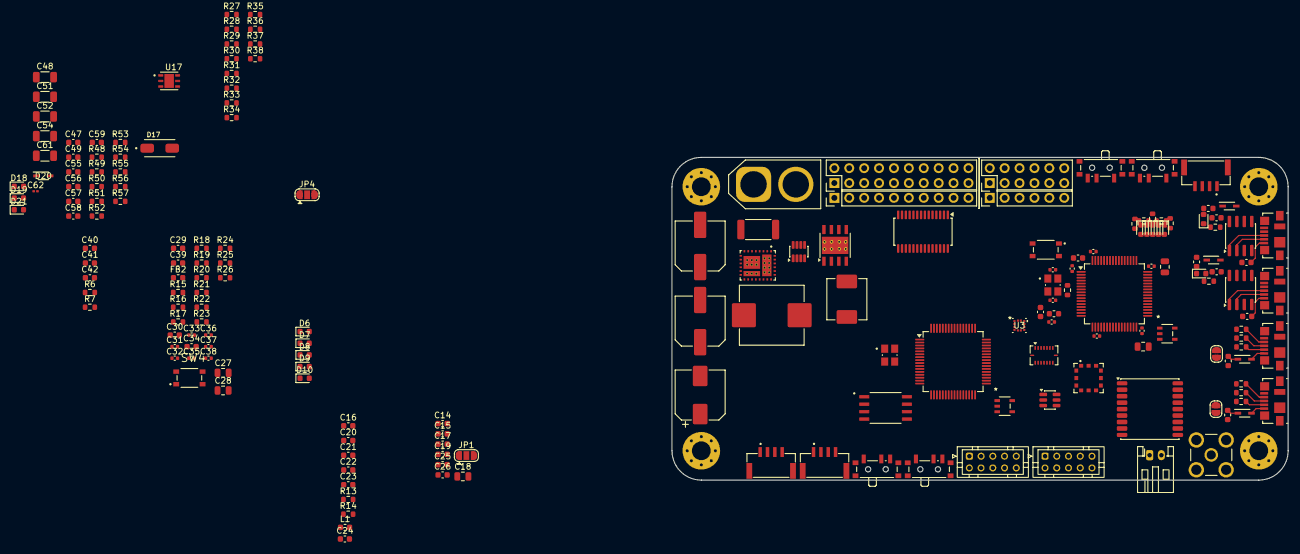
[picture p37: board gravitumfcs.kicad_pcb from above]

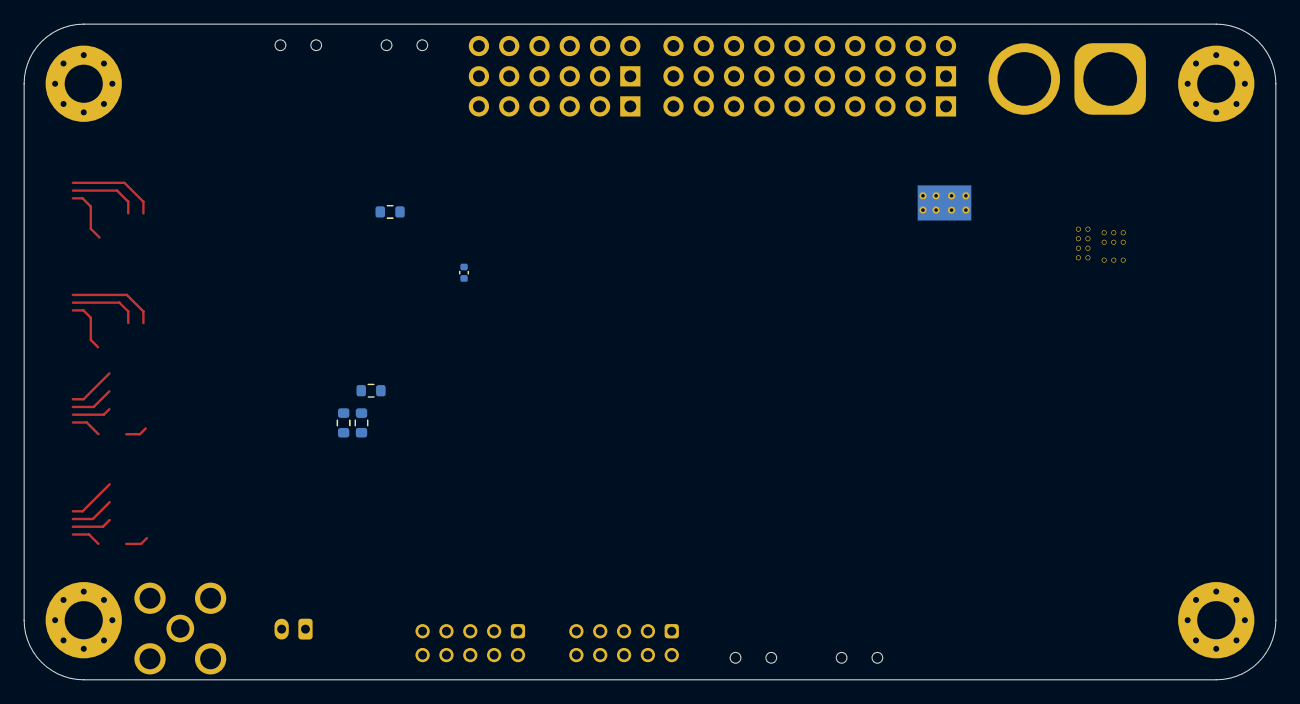
[picture p38: board gravitumfcs.kicad_pcb from below]

Board: 4 copper layers, 105.0 x 55.0 mm, 194 parts (5 on the bottom side), 179 nets.

Parts:
C1, C2, C27, C28: 2u2; C_0805_2012Metric
C3, C29: 10u; C_0603_1608Metric
C4, C5, C6, C7, C8, C9, C11, C31, C32, C33, C35, C36, C37, C38: 100n; C_0402_1005Metric
C10, C25, C26, C39: 1u; C_0603_1608Metric
C12, C13: 25p; C_0402_1005Metric
C14, C15, C17, C19, C21, C22, C23, C40, C41, C42, C43, C44, C45, C46, C47, C57, C58: 100n; C_0603_1608Metric
C16: 220n; C_0603_1608Metric
C18: 10u; C_0805_2012Metric
C20: 1n; C_0603_1608Metric
C24, C49: 10n; C_0603_1608Metric
C30, C34: 25p; C_0603_1608Metric
C48, C51, C52: 10u; C_1206_3216Metric
C50: 220u; CP_Elec_8x10
C53, C60: 100u; C_Elec_8x10.2
C54, C61: 47u; C_1206_3216Metric
C55, C56: 2u2; C_0603_1608Metric
C59: 4n7; C_0603_1608Metric
C62: 100n; C_0201_0603Metric
D1, D2, D6, D7: R; LED_0603_1608Metric
D3, D8, D12, D14, D18, D19, D21: G; LED_0603_1608Metric
D4, D5, D9, D10: B; LED_0603_1608Metric
D11, D13, D15, D16: Schottky; SOD2713X115N
D17: B340A; DIOM5226X240N
D20: SD103AWS; SOD2713X115N
FB1, FB2, FB3, FB4, FB5, FB6: FerriteBead; L_0603_1608Metric
J1: RFPC-SMA28-F; GRADCONN_RFPC-SMA28-F
J2, J5, J17: SM04B-GHS-TB_LF__SN_-; JST_SM04B-GHS-TB_LF__SN_-
J3: Conn_02x06_Odd_Even; PinHeader_2x06_P2.54mm_Vertical
J4: Conn_01x06; PinHeader_1x06_P2.54mm_Vertical
J7: Conn_02x10_Odd_Even; PinHeader_2x10_P2.54mm_Vertical
J8: Conn_01x10; PinHeader_1x10_P2.54mm_Vertical
J9, J10, J11, J12: USB_B_Micro; USB_Micro-B_Molex_47346-0001
J13, J14: Conn_02x05_Odd_Even; JST_PHD_B10B-PHDSS_2x05_P2.00mm_Vertical
J15: Conn_01x02; JST_PH_S2B-PH-K_1x02_P2.00mm_Horizontal
J16: Conn_01x02; AMASS_XT60-M_1x02_P7.20mm_Vertical
JP1, JP4: SolderJumper_3_Open; SolderJumper-3_P1.3mm_Open_RoundedPad1.0x1.5mm
JP2, JP3: SolderJumper_2_Open; SolderJumper-2_P1.3mm_Open_RoundedPad1.0x1.5mm
L1: 27n; L_0603_1608Metric
L2: 15u; L_APV_APH0615
L3: 15u; L_APV_APH1030
R1, R3, R6, R7, R14, R23, R24, R48, R52, R53: 10k; R_0603_1608Metric
R2, R20: 620; R_0603_1608Metric
R4, R5, R21, R22, R25, R26: 4k7; R_0603_1608Metric
R8, R9, R10, R11, R12, R15, R16, R17, R39, R40, R50, R51, R57: 560; R_0603_1608Metric
R13, R27, R28, R29, R30, R31, R32, R33, R34, R35, R36: 10; R_0603_1608Metric
R18, R19: 100; R_0603_1608Metric
R37, R38: 0; R_0603_1608Metric
R41, R42, R43, R44, R45, R46: 22; R_0603_1608Metric
R47: 0.01; R_2512_6332Metric
R49: 3k24; R_0603_1608Metric
R54: 19k6; R_0603_1608Metric
R55, R56: R; R_0603_1608Metric
SW1, SW4: SW_Push_Dual; SW_TL3365AF180QG
SW2, SW3, SW5, SW6: SW_SPDT_312; SW_SPDT_PCM12
U1, U8: STM32F405RGTx; LQFP-64_10x10mm_P0.5mm
U2: BMI088; Bosch_LGA-16_4.5x3mm_P0.5mm_LayoutBorder7x1y_ClockwisePinNu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
U3: IIS2MDCTR; LGA-12_2X2X0P7_STM
U4: MPRLS0025PA00001A; XDCR_MPRLS0025PA00001A
U5: TMP100; SOT-23-6
U6, U10: 24CW1280T-I/OT; SOT-23-5_2P9X1P6_MCH
U7: MAX-M8Q; ublox_MAX
U9: PCA9685PW; TSSOP-28_4.4x9.7mm_P0.65mm
U11: AT45DB641E-SHN2B-T; SOIC127P798X216-8N
U12, U13: CH330N; SOIC-8_3.9x4.9mm_P1.27mm
U14: INA219AxDCN; SOT-23-8
U15: MIC26903YJL-TR; CONV_MIC28510YJL-TR
U16: TPS5430DDA; TI_SO-PowerPAD-8_ThermalVias
U17: LD39200PU33R; SON95P300X300X100-7N
Y1, Y2: 25MHz; XTAL_ABM8G-25.000MHZ-18-D2Y-T

Connections:
+3.3V: C3.1, C4.1, C5.1, C6.1, C7.1, C8.1, C9.1, C10.1, C14.2, C15.1, C17.2, C18.2, C19.2, C21.1, C22.1, C23.2, C25.2, C26.2, C29.1, C31.1, C33.1, C35.1, C36.1, C37.1, C38.1, C39.1, C40.1, C41.2, C42.1, C47.1, C52.1, D19.2 (A), FB1.1, FB2.1, J13.7, J13.8, J14.7, J14.8, JP1.3 (B), JP4.1 (A), R4.1, R5.1, R6.2, R7.2, R14.1, R21.1, R22.1, R25.1, R26.1, SW2.3 (A), SW3.3 (A), SW5.3 (A), SW6.3 (A), U1.1 (VBAT), U1.19 (VDD), U1.32 (VDD), U1.48 (VDD), U1.64 (VDD), U2.3 (VDD), U2.11 (VDDIO), U3.3 (CS), U3.9 (VDD), U3.10 (VDD_IO), U4.9 (RES), U4.12 (VDD), U5.4 (V+), U6.4 (VCC), U7.7 (VCC_IO), U7.8 (VCC), U8.1 (VBAT), U8.19 (VDD), U8.32 (VDD), U8.48 (VDD), U8.64 (VDD), U9.28 (VDD), U10.4 (VCC), U11.6 (VCC), U14.4 (VS), U17.1 (OUT), U17.2 (SENSE)
+5V: C50.1, C51.1, C62.1, D18.2 (A), FB3.2, FB4.2, FB5.2, FB6.2, J2.1, J5.1, J17.1, L2.2, R48.1, U17.5 (EN), U17.6 (IN)
+6V: C59.1, C60.1, C61.1, D21.2 (A), J3.1, J3.3, J3.5, J3.7, J7.1, J7.3, J7.5, J7.7, J7.9, J7.11, J7.13, J7.15, J7.17, J7.19, L3.2, R55.1
FCU_BOOT0: R23.1, U8.60 (BOOT0)
FCU_BOOT1: R24.1, U8.28 (PB2)
FCU_ENG_PROP_1: J4.6, U8.40 (PC9)
FCU_ENG_PROP_2: J4.5, U8.39 (PC8)
FCU_FCS_AIRLN: J4.1, U8.37 (PC6)
FCU_FCS_ELEV: J4.2, U8.38 (PC7)
FCU_FCS_FLPS: J4.4, U8.27 (PB1)
FCU_FCS_RUDD: J4.3, U8.26 (PB0)
FCU_GPIO_A: R27.1, U8.11 (PC3)
FCU_GPIO_B: R28.1, U8.10 (PC2)
FCU_GPIO_C: R29.1, U8.9 (PC1)
FCU_GPIO_D: R30.1, U8.8 (PC0)
FCU_GPIO_E: R31.1, U8.4 (PC15)
FCU_GPIO_F: R32.1, U8.3 (PC14)
FCU_GPIO_G: R33.1, U8.2 (PC13)
FCU_GPIO_H: R34.1, U8.20 (PA4)
FCU_I2C1_SCL: R26.2, R37.2, U8.61 (PB8)
FCU_I2C1_SDA: R25.2, R38.1, U8.62 (PB9)
FCU_I2C2_SCL: R22.2, U8.29 (PB10), U9.26 (SCL), U10.1 (SCL), U14.6 (SDA)
FCU_I2C2_SDA: R21.2, U8.30 (PB11), U9.27 (SDA), U10.3 (SDA), U14.5 (SCL)
FCU_LED_A: D6.2 (A), U8.57 (PB5)
FCU_LED_B: D7.2 (A), U8.56 (PB4)
FCU_LED_C: D8.2 (A), U8.55 (PB3)
FCU_LED_D: D9.2 (A), U8.54 (PD2)
FCU_LED_E: D10.2 (A), U8.53 (PC12)
FCU_NRST: C32.1, J13.1, SW4.1, SW4.3, U8.7 (NRST)
FCU_OSC_IN: C30.1, U8.5 (PH0), Y2.1
FCU_OSC_OUT: R20.1, U8.6 (PH1)
FCU_SPI1_CS_FLASH: U8.24 (PC4), U11.4 (~CS)
FCU_SPI1_MISO: U8.22 (PA6), U11.8 (SO)
FCU_SPI1_MOSI: U8.23 (PA7), U11.1 (SI)
FCU_SPI1_SCK: U8.21 (PA5), U11.2 (SCK)
FCU_SWCLK: J13.6, U8.49 (PA14)
FCU_SWDIO: J13.2, U8.46 (PA13)
FCU_UART1_RX: R35.1, U8.59 (PB7)
FCU_UART1_TX: R36.1, U8.58 (PB6)
FCU_UART2_RX: U8.17 (PA3), U12.7 (RXD)
FCU_UART2_TX: U8.16 (PA2), U12.6 (TXD)
FCU_UART3_RX: J17.3, U8.52 (PC11)
FCU_UART3_TX: J17.2, U8.51 (PC10)
FCU_UART4_RX: J5.3, U8.15 (PA1)
FCU_UART4_TX: J5.2, U8.14 (PA0)
FCU_USB_OTG_FS_D+: R44.2, U8.45 (PA12)
FCU_USB_OTG_FS_D-: R45.2, U8.44 (PA11)
FCU_USB_OTG_FS_ID: R46.2, U8.43 (PA10)
FCU_USB_OTG_FS_VBUS: JP3.2 (B), U8.42 (PA9)
FCU_VDDA: FB2.2, U8.13 (VDDA)
GND: C1.2, C2.2, C3.2, C4.2, C5.2, C6.2, C7.2, C8.2, C9.2, C10.2, C11.2, C12.2, C13.2, C14.1, C15.2, C16.2, C17.1, C18.1, C19.1, C21.2, C22.2, C23.1, C24.1, C25.1, C26.1, C27.2, C28.2, C29.2, C30.2, C31.2, C32.2, C33.2, C34.2, C35.2, C36.2, C37.2, C38.2, C39.2, C40.2, C41.1, C42.2, C43.2, C44.1, C45.1, C46.2, C47.2, C48.1, C50.2, C51.2, C52.2, C53.2, C54.2, C55.2, C56.1, C60.2, C61.2, C62.2, D17.2 (A), J1.G1, J1.G2, J1.G3, J1.G4, J2.4, J2.SH1 (SHIELD), J2.SH2 (SHIELD), J3.2, J3.4, J3.6, J3.8, J3.10, J3.12, J5.4, J5.SH1 (SHIELD), J5.SH2 (SHIELD), J7.2, J7.4, J7.6, J7.8, J7.10, J7.12, J7.14, J7.16, J7.18, J7.20, J9.5 (GND), J9.6 (Shield), J10.5 (GND), J10.6 (Shield), J11.5 (GND), J11.6 (Shield), J12.5 (GND), J12.6 (Shield), J13.3, J13.4, J14.3, J14.4, J15.2, J16.2, J17.4, J17.SH1 (SHIELD), J17.SH2 (SHIELD), JP1.1 (A), R8.2, R9.2, R10.2, R11.2, R12.2, R15.2, R16.2, R17.2, R18.2, R19.2, R39.2, R40.2, R49.2, R50.2, R51.2, R56.2, R57.1, SW1.2, SW1.4, SW2.2 (C), SW3.2 (C), SW4.2, SW4.4, SW5.2 (C), SW6.2 (C), U1.12 (VSSA), U1.18 (VSS), U1.63 (VSS), U2.2 (GNDA), U2.4 (GNDA), U2.6 (GNDIO), U2.7 (PS), U3.6 (GND), U3.8 (GND), U4.10 (VSS), U5.2 (GND), U5.3 (ADD1), U5.5 (ADD0), U6.2 (VSS), U7.1 (GND), U7.10 (GND), U7.12 (GND), U8.12 (VSSA), U8.18 (VSS), U8.63 (VSS), U9.1 (A0), U9.2 (A1), U9.3 (A2), U9.4 (A3), U9.5 (A4), U9.14 (VSS), U9.23 (~OE), U9.24 (A5), U9.25 (EXTCLK), U10.2 (VSS), U11.7 (GND), U12.3 (GND), U13.3 (GND), U14.3 (GND), U14.7 (A0), U14.8 (A1), U15.2 (PGND), U15.5 (PGND), U15.6 (PGND), U15.7 (PGND), U15.8 (PGND), U15.21 (PGND), U15.23 (SGND), U15.29 (EPAD), U16.6 (GND), U16.9 (GNDPAD), U17.3 (GND), U17.7 (EXP), Y1.2 (G), Y1.4 (G), Y2.2 (G), Y2.4 (G)
GNSS_BKP_BAT: JP4.2 (C), U7.6 (V_BCKP)
NU_ACCEL_INT: U1.9 (PC1), U2.16 (INT1)
NU_BARO_INT: U1.10 (PC2), U4.8 (EOC)
NU_BOOT0: R1.1, U1.60 (BOOT0)
NU_BOOT1: R3.1, U1.28 (PB2)
NU_GNSS_LNA_EN: U1.27 (PB1), U7.13 (LNA_EN)
NU_GNSS_NRST: R14.2, U1.25 (PC5), U7.9 (~RESET)
NU_GNSS_PSS: U1.26 (PB0), U7.4 (TIMEPULSE)
NU_GPIO_A: R27.2, U1.41 (PA8)
NU_GPIO_B: R28.2, U1.40 (PC9)
NU_GPIO_C: R29.2, U1.39 (PC8)
NU_GPIO_D: R30.2, U1.38 (PC7)
NU_GPIO_E: R31.2, U1.37 (PC6)
NU_GPIO_F: R32.2, U1.36 (PB15)
NU_GPIO_G: R33.2, U1.35 (PB14)
NU_GPIO_H: R34.2, U1.34 (PB13)
NU_GYRO_INT: U1.8 (PC0), U2.12 (INT3)
NU_I2C1_SCL: R37.1, U1.61 (PB8)
NU_I2C1_SDA: R38.2, U1.62 (PB9)
NU_I2C2_SCL: R5.2, U1.29 (PB10), U3.1 (SCL/SPC), U4.3 (SCLK/SCL), U5.1 (SCL), U6.1 (SCL)
NU_I2C2_SDA: R4.2, U1.30 (PB11), U3.4 (SDA/SDI/SDO), U4.2 (MOSI/SDA), U5.6 (SDA), U6.3 (SDA)
NU_LED_A: D1.2 (A), U1.53 (PC12)
NU_LED_B: D2.2 (A), U1.54 (PD2)
NU_LED_C: D3.2 (A), U1.55 (PB3)
NU_LED_D: D4.2 (A), U1.56 (PB4)
NU_LED_E: D5.2 (A), U1.57 (PB5)
NU_MAG_INT: U1.11 (PC3), U3.7 (INT/DRDY)
NU_NRST: C11.1, J14.1, SW1.1, SW1.3, U1.7 (NRST)
NU_OSC_IN: C12.1, U1.5 (PH0), Y1.1
NU_OSC_OUT: R2.1, U1.6 (PH1)
NU_SPI1_CS_ACCEL: U1.24 (PC4), U2.14 (~CSB1)
NU_SPI1_CS_GYRO: U1.20 (PA4), U2.5 (~CSB2)
NU_SPI1_MISO: U1.22 (PA6), U2.10 (SDO2), U2.15 (SDO1)
NU_SPI1_MOSI: U1.23 (PA7), U2.9 (SDI/SDA)
NU_SPI1_SCK: U1.21 (PA5), U2.8 (SCK/SCL)
NU_SWCLK: J14.6, U1.49 (PA14)
NU_SWDIO: J14.2, U1.46 (PA13)
NU_UART1_RX: R36.2, U1.59 (PB7)
NU_UART1_TX: R35.2, U1.58 (PB6)
NU_UART2_RX: U1.17 (PA3), U13.7 (RXD)
NU_UART2_TX: U1.16 (PA2), U13.6 (TXD)
NU_UART3_RX: U1.52 (PC11), U7.2 (TXD)
NU_UART3_TX: U1.51 (PC10), U7.3 (RXD)
NU_UART4_RX: J2.2, U1.15 (PA1)
NU_UART4_TX: J2.3, U1.14 (PA0)
NU_USB_FS_D+: R41.2, U1.45 (PA12)
NU_USB_FS_D-: R42.2, U1.44 (PA11)
NU_USB_FS_ID: R43.2, U1.43 (PA10)
NU_USB_FS_VBUS: JP2.2 (B), U1.42 (PA9)
NU_VDDA: FB1.2, U1.13 (VDDA)
unnamed: C13.1, R2.2, Y1.3
unnamed: C34.1, R20.2, Y2.3
unnamed: C58.2, R54.1
unnamed: D1.1 (K), R8.1
unnamed: D2.1 (K), R9.1
unnamed: D3.1 (K), R10.1
unnamed: D4.1 (K), R11.1
unnamed: D5.1 (K), R12.1
unnamed: D6.1 (K), R15.1
unnamed: D7.1 (K), R16.1
unnamed: D8.1 (K), R17.1
unnamed: D9.1 (K), R18.1
unnamed: D10.1 (K), R19.1
unnamed: C43.1, D11.2 (A), D12.2 (A), J9.1 (VBUS), U12.5 (VCC)
unnamed: D11.1 (K), FB3.1
unnamed: D12.1 (K), R39.1
unnamed: C46.1, D13.2 (A), D14.2 (A), J10.1 (VBUS), U13.5 (VCC)
unnamed: D13.1 (K), FB4.1
unnamed: D14.1 (K), R40.1
unnamed: D15.2 (A), J11.1 (VBUS), JP2.1 (A)
unnamed: D15.1 (K), FB5.1
unnamed: D16.2 (A), J12.1 (VBUS), JP3.1 (A)
unnamed: D16.1 (K), FB6.1
unnamed: C49.2, D17.1 (K), L2.1, U16.8 (PH)
unnamed: D18.1 (K), R50.1
unnamed: D19.1 (K), R51.1
unnamed: C56.2, D20.2 (A), R53.1, U15.28 (VDD)
unnamed: D21.1 (K), R57.2
unnamed: J9.3 (D+), U12.1 (UD+)
unnamed: J9.2 (D-), U12.2 (UD-)
unnamed: J10.3 (D+), U13.1 (UD+)
unnamed: J10.2 (D-), U13.2 (UD-)
unnamed: J11.3 (D+), R41.1
unnamed: J11.2 (D-), R42.1
unnamed: J11.4 (ID), R43.1
unnamed: J12.3 (D+), R44.1
unnamed: J12.2 (D-), R45.1
unnamed: J12.4 (ID), R46.1
unnamed: J15.1, JP4.3 (B)
unnamed: JP1.2 (C), U7.18 (~SAFEBOOT)
unnamed: L1.1, R13.1
unnamed: R1.2, SW2.1 (B)
unnamed: R3.2, SW3.1 (B)
unnamed: R23.2, SW5.1 (B)
unnamed: R24.2, SW6.1 (B)
unnamed: C2.1, U1.31 (VCAP_1)
unnamed: C1.1, U1.47 (VCAP_2)
unnamed: C16.1, U3.5 (C1)
unnamed: C20.1, U4.4 (VO+)
unnamed: C20.2, U4.6 (VO-)
unnamed: J1.1, L1.2, U7.11 (RF_IN)
unnamed: C24.2, R13.2, U7.14 (VCC_RF)
unnamed: C27.1, U8.31 (VCAP_1)
unnamed: C28.1, U8.47 (VCAP_2)
unnamed: R7.1, U11.3 (~RESET)
unnamed: R6.1, U11.5 (~WP)
unnamed: C44.2, U12.8 (V3)
unnamed: C45.2, U13.8 (V3)
unnamed: C55.1, U15.1 (PVDD)
unnamed: C49.1, U16.1 (BOOT)
unnamed: R48.2, R49.1, U16.4 (VSENSE)
PS_BST: C57.2, D20.1 (K), U15.20 (BST)
PS_CS: C57.1, C58.1, L3.1, U15.4 (SW), U15.9 (SW), U15.10 (SW), U15.11 (SW), U15.12 (SW), U15.22 (CS)
PS_EN: R52.2, U15.26 (EN)
PS_FB: C59.2, R54.2, R55.2, R56.1, U15.24 (FB)
PS_PG: R53.2, U15.25 (PG)
PS_VIN: C48.2, C53.1, C54.1, R47.2, R52.1, U14.2 (IN-), U15.13 (PVIN), U15.14 (PVIN), U15.15 (PVIN), U15.16 (PVIN), U15.17 (PVIN), U15.18 (PVIN), U15.19 (PVIN), U15.27 (VIN), U16.7 (VIN)
PS_VIN+: J16.1, R47.1, U14.1 (IN+)
PWM_A: J8.1, U9.16 (LED9)
PWM_B: J8.2, U9.15 (LED8)
PWM_C: J8.3, U9.13 (LED7)
PWM_D: J8.4, U9.12 (LED6)
PWM_E: J8.5, U9.11 (LED5)
PWM_F: J8.6, U9.10 (LED4)
PWM_G: J8.7, U9.9 (LED3)
PWM_H: J8.8, U9.8 (LED2)
PWM_I: J8.9, U9.7 (LED1)
PWM_J: J8.10, U9.6 (LED0)
