brenulevi/GravitumFCS/Hardware/aircraft.kicad_pcb

## KiCad design Hardware/aircraft.kicad_pcb (continued)

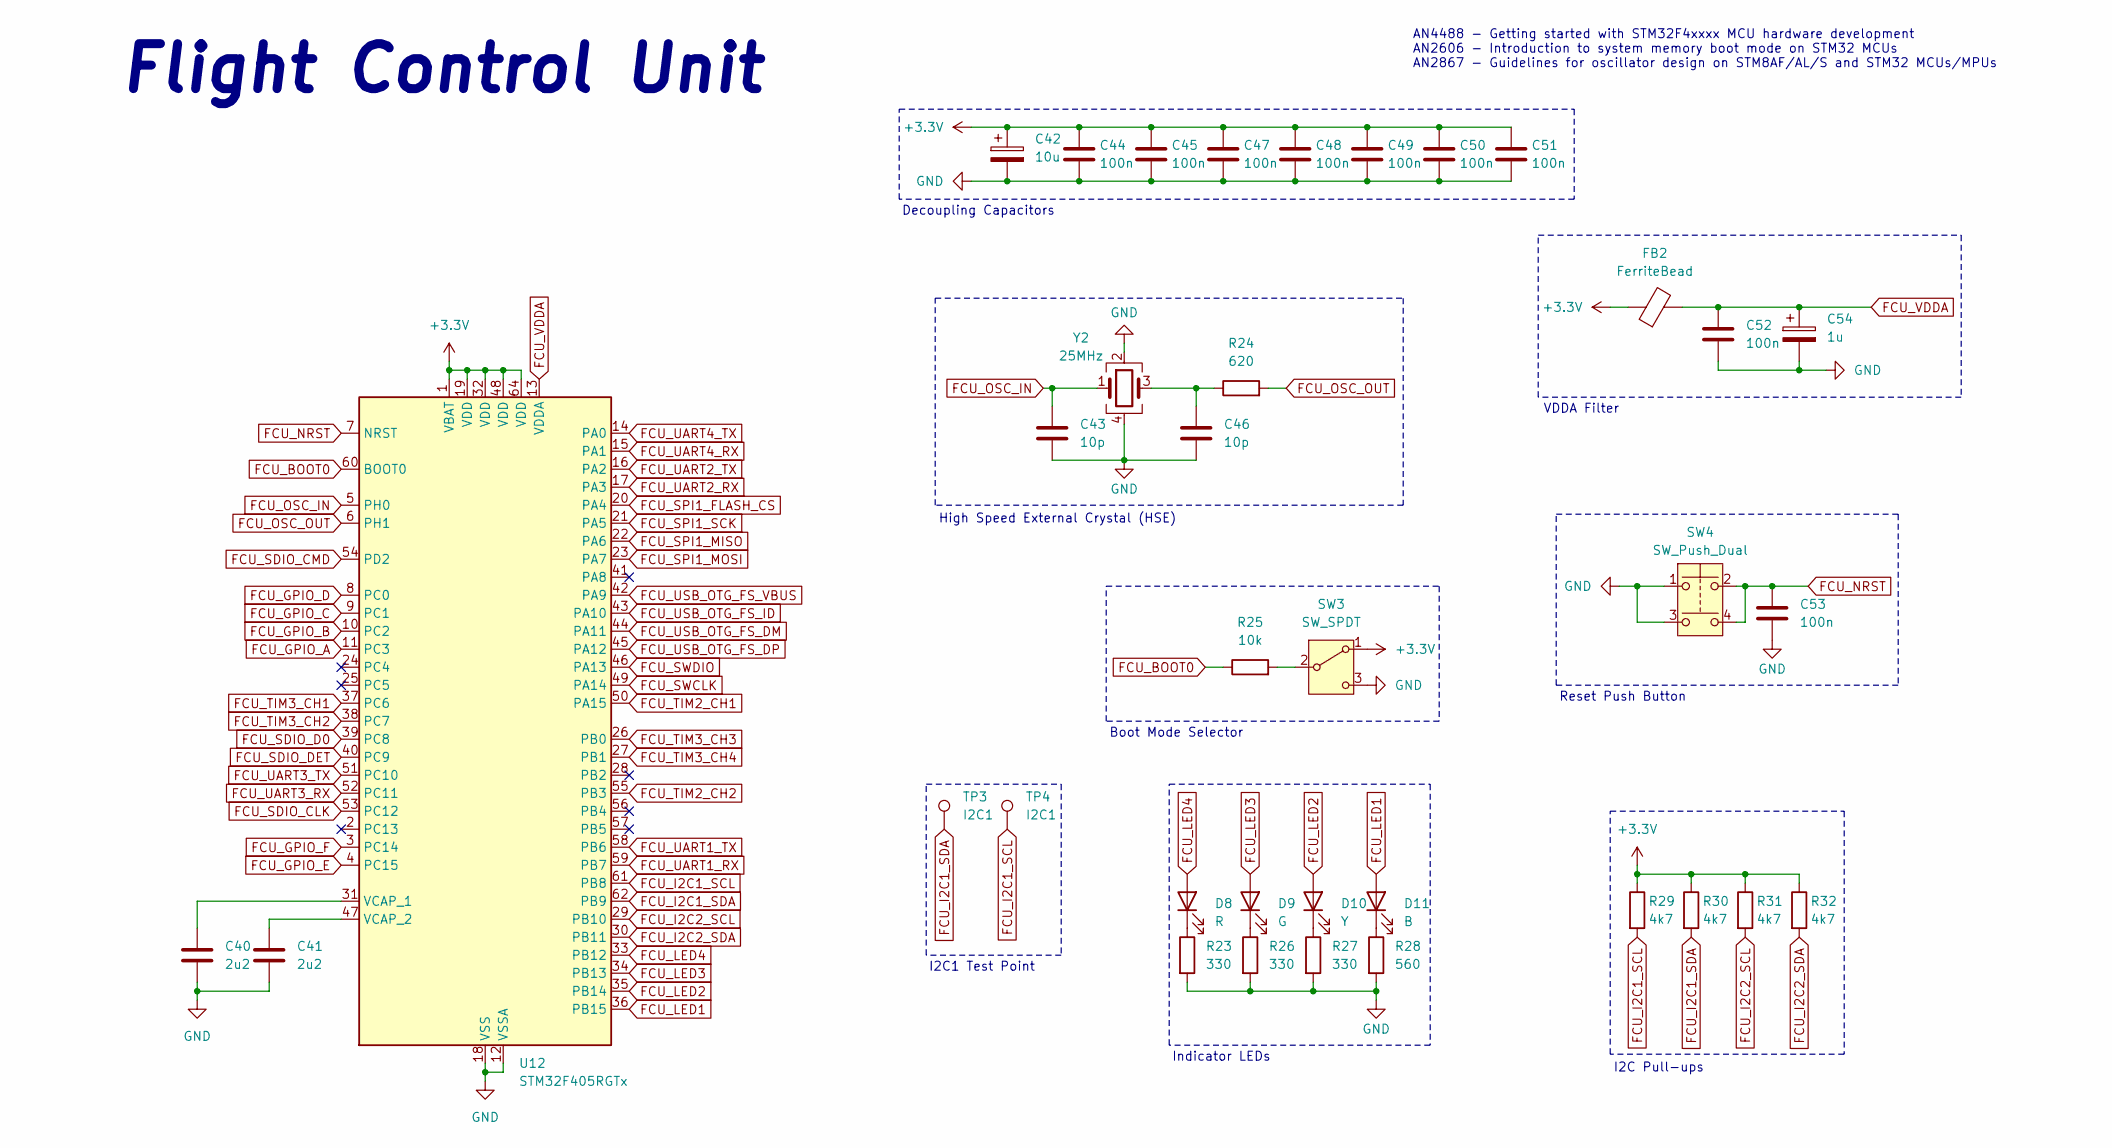
[picture p43: schematic flight_control_unit.kicad_sch, Flight Control Unit]

Parts:
C40, C41: 2u2; C_0402_1005Metric; MPN CL10B225KP8NNNC
C42: 10u; C_0603_1608Metric; MPN TAJA106K010TNJ
C43, C46: 10p; C_0402_1005Metric; MPN 885012005007
C44, C45, C47, C48, C49, C50, C51, C52: 100n; C_0402_1005Metric; MPN CL05B104KP5NNNC
C53: 100n; C_0402_1005Metric; MPN C0603C104K8RACTU
C54: 1u; CP_EIA-1608-08_AVX-J; MPN T491A105K010AT
D8: R; LED_0402_1005Metric; MPN LTST-C171KRKT
D9: G; LED_0402_1005Metric; MPN LTST-C170GKT
D10: Y; LED_0402_1005Metric; MPN LTST-C171YKT
D11: B; LED_0402_1005Metric; MPN LTST-C171TBKT
FB2: FerriteBead; L_0402_1005Metric; MPN HZ0805E601R-10
R23, R26, R27: 330; R_0402_1005Metric; MPN RC0603JR-07330RL
R24: 620; R_0402_1005Metric; MPN RC0603FR-07620RL
R25: 10k; R_0402_1005Metric; MPN RC0603FR-0710KL
R28: 560; R_0402_1005Metric; MPN RMCF0603FT560R
R29, R30, R31, R32: 4k7; R_0402_1005Metric; MPN ERJ-3EKF4701V
SW3: SW_SPDT; SW_SPDT_PCM12; MPN PCM12SMTR
SW4: SW_Push_Dual; SW4_PTS815 SJM 250 SMTR LFS_CNK; MPN PTS815SJM250SMTRLFS
TP3, TP4: I2C1; TestPoint_Pad_D1.0mm
U12: STM32F405RGTx; LQFP-64_10x10mm_P0.5mm; MPN STM32F405RGT6
Y2: 25MHz; Crystal_SMD_Abracon_ABM8G-4Pin_3.2x2.5mm; MPN ABM8G-25.000MHZ-B4Y-T3

Connections:
+3.3V: C42.1, C44.1, C45.1, C47.1, C48.1, C49.1, C50.1, C51.1, FB2.1, R29.1, R30.1, R31.1, R32.1, SW3.1 (A), U12.1 (VBAT), U12.19 (VDD), U12.32 (VDD), U12.48 (VDD), U12.64 (VDD); also elsewhere on the board
FCU_BOOT0: R25.1, U12.60 (BOOT0)
FCU_GPIO_A: U12.11 (PC3); also elsewhere on the board
FCU_GPIO_B: U12.10 (PC2); also elsewhere on the board
FCU_GPIO_C: U12.9 (PC1); also elsewhere on the board
FCU_GPIO_D: U12.8 (PC0); also elsewhere on the board
FCU_GPIO_E: U12.4 (PC15); also elsewhere on the board
FCU_GPIO_F: U12.3 (PC14); also elsewhere on the board
FCU_I2C1_SCL: R29.2, TP4.1, U12.61 (PB8); also elsewhere on the board
FCU_I2C1_SDA: R30.2, TP3.1, U12.62 (PB9); also elsewhere on the board
FCU_I2C2_SCL: R31.2, U12.29 (PB10); also elsewhere on the board
FCU_I2C2_SDA: R32.2, U12.30 (PB11); also elsewhere on the board
FCU_LED1: D11.2 (A), U12.36 (PB15)
FCU_LED2: D10.2 (A), U12.35 (PB14)
FCU_LED3: D9.2 (A), U12.34 (PB13)
FCU_LED4: D8.2 (A), U12.33 (PB12)
FCU_NRST: C53.1, SW4.2, SW4.4, U12.7 (NRST); also elsewhere on the board
FCU_OSC_IN: C43.1, U12.5 (PH0), Y2.1
FCU_OSC_OUT: R24.2, U12.6 (PH1)
FCU_SDIO_CLK: U12.53 (PC12); also elsewhere on the board
FCU_SDIO_CMD: U12.54 (PD2); also elsewhere on the board
FCU_SDIO_D0: U12.39 (PC8); also elsewhere on the board
FCU_SDIO_DET: U12.40 (PC9); also elsewhere on the board
FCU_SPI1_FLASH_CS: U12.20 (PA4); also elsewhere on the board
FCU_SPI1_MISO: U12.22 (PA6); also elsewhere on the board
FCU_SPI1_MOSI: U12.23 (PA7); also elsewhere on the board
FCU_SPI1_SCK: U12.21 (PA5); also elsewhere on the board
FCU_SWCLK: U12.49 (PA14); also elsewhere on the board
FCU_SWDIO: U12.46 (PA13); also elsewhere on the board
FCU_TIM2_CH1: U12.50 (PA15); also elsewhere on the board
FCU_TIM2_CH2: U12.55 (PB3); also elsewhere on the board
FCU_TIM3_CH1: U12.37 (PC6); also elsewhere on the board
FCU_TIM3_CH2: U12.38 (PC7); also elsewhere on the board
FCU_TIM3_CH3: U12.26 (PB0); also elsewhere on the board
FCU_TIM3_CH4: U12.27 (PB1); also elsewhere on the board
FCU_UART1_RX: U12.59 (PB7); also elsewhere on the board
FCU_UART1_TX: U12.58 (PB6); also elsewhere on the board
FCU_UART2_RX: U12.17 (PA3); also elsewhere on the board
FCU_UART2_TX: U12.16 (PA2); also elsewhere on the board
FCU_UART3_RX: U12.52 (PC11); also elsewhere on the board
FCU_UART3_TX: U12.51 (PC10); also elsewhere on the board
FCU_UART4_RX: U12.15 (PA1); also elsewhere on the board
FCU_UART4_TX: U12.14 (PA0); also elsewhere on the board
FCU_USB_OTG_FS_ID: U12.43 (PA10); also elsewhere on the board
FCU_USB_OTG_FS_VBUS: U12.42 (PA9); also elsewhere on the board
FCU_VDDA: C52.1, C54.1, FB2.2, U12.13 (VDDA)
GND: C40.2, C41.2, C42.2, C43.2, C44.2, C45.2, C46.2, C47.2, C48.2, C49.2, C50.2, C51.2, C52.2, C53.2, C54.2, R23.2, R26.2, R27.2, R28.2, SW3.3 (C), SW4.1, SW4.3, U12.12 (VSSA), U12.18 (VSS), U12.63 (VSS), Y2.2, Y2.4; also elsewhere on the board
unnamed: C46.1, R24.1, Y2.3
unnamed: D8.1 (K), R23.1
unnamed: D9.1 (K), R26.1
unnamed: D10.1 (K), R27.1
unnamed: D11.1 (K), R28.1
unnamed: R25.2, SW3.2 (B)
unnamed: C40.1, U12.31 (VCAP_1)
unnamed: C41.1, U12.47 (VCAP_2)

Notes on the sheet:
Reset Push Button
VDDA Filter
Decoupling Capacitors
I2C Pull-ups
Flight Control Unit
AN4488 - Getting started with STM32F4xxxx MCU hardware development AN2606 - Introduction to system memory boot mode on STM32 MCUs AN2867 - Guidelines for oscillator design on STM8AF/AL/S and STM32 MCUs/MPUs
Indicator LEDs
Boot Mode Selector
High Speed External Crystal (HSE)
I2C1 Test Point

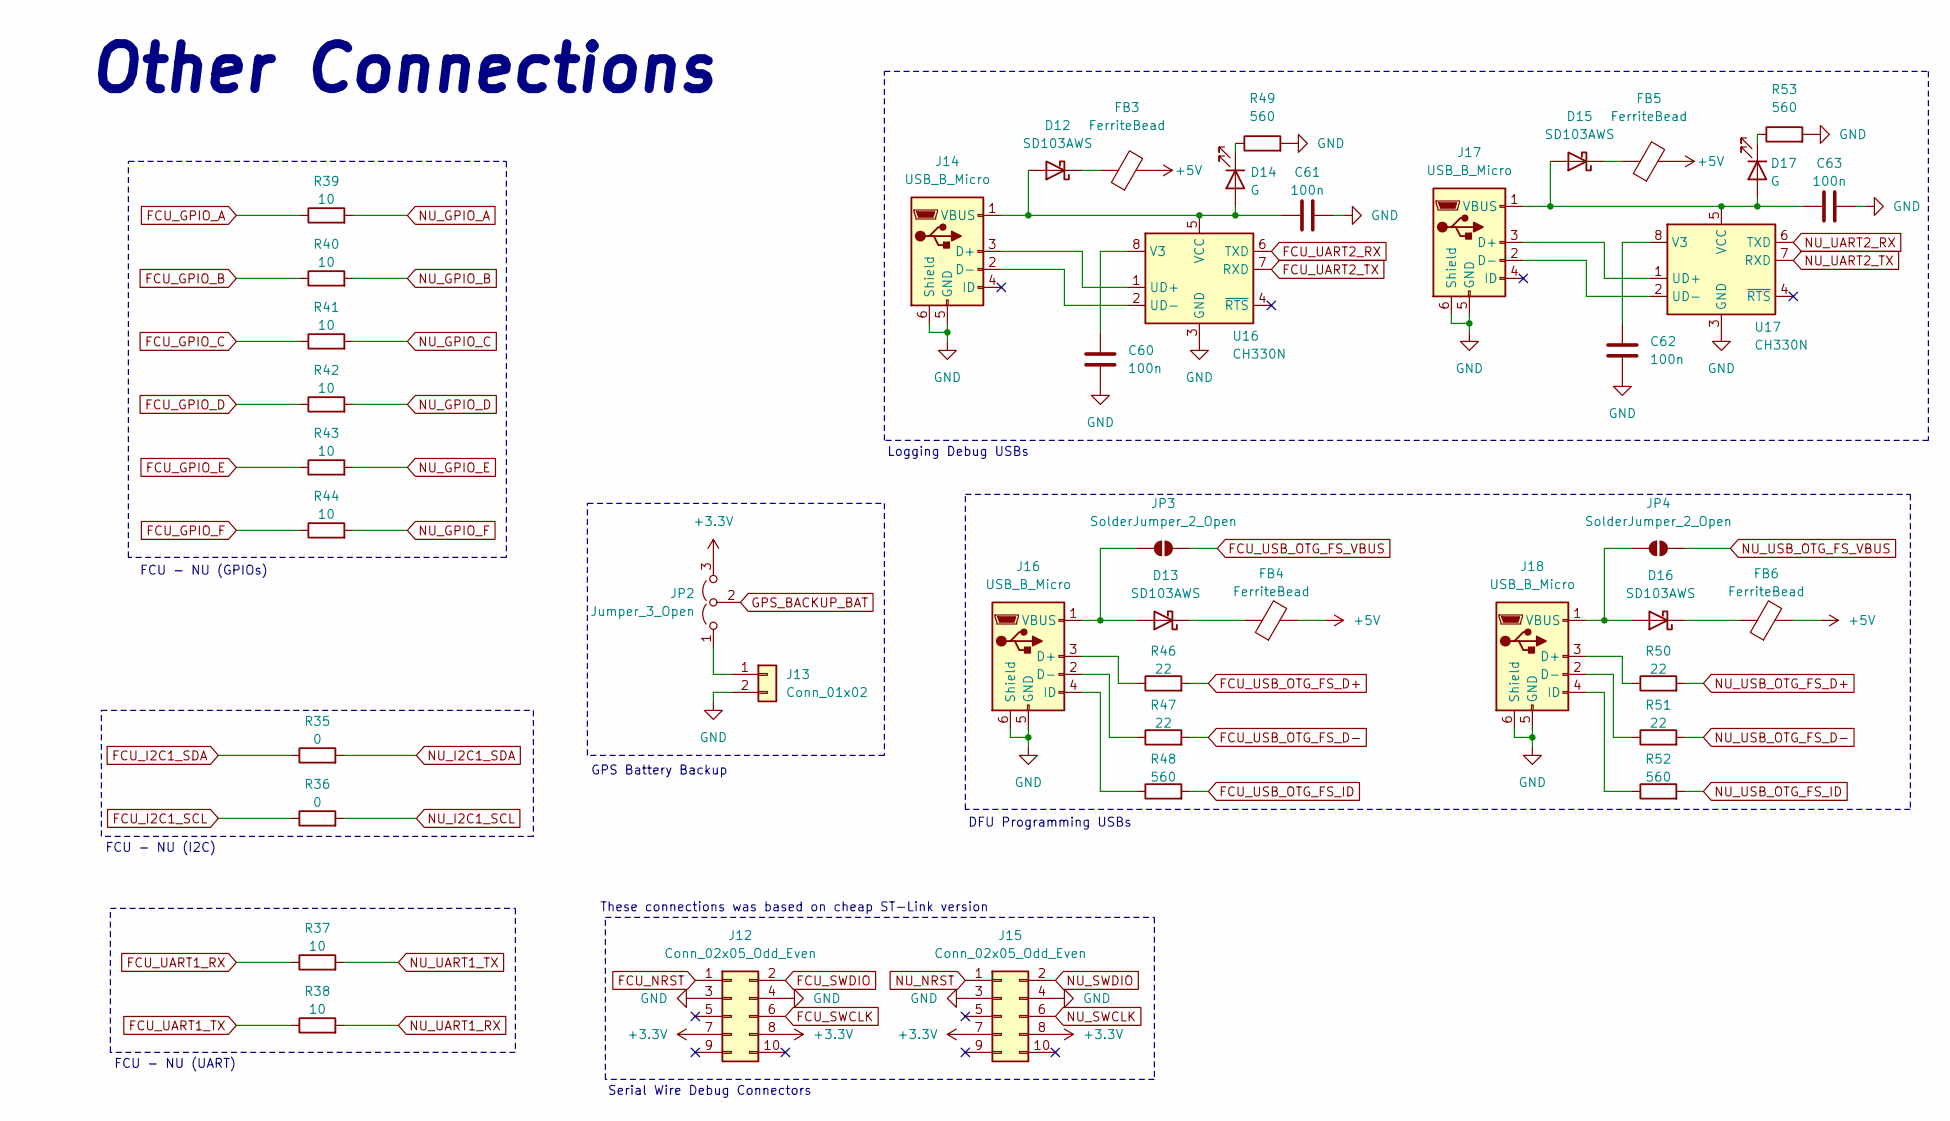
[picture p44: schematic other_connections.kicad_sch, Other Connections]

Parts:
C60, C62: 100n; C_0402_1005Metric; MPN C0603C104K8RACTU
C61, C63: 100n; C_0603_1608Metric; MPN C0603C104K8RACTU
D12, D13, D15, D16: SD103AWS; D_SOD-323_HandSoldering; MPN SD103AWS
D14, D17: G; LED_0402_1005Metric; MPN LTST-S270KGKT
FB3, FB4, FB5, FB6: FerriteBead; L_0603_1608Metric; MPN HZ0805E601R-10
J12, J15: Conn_02x05_Odd_Even; JST_PHD_B10B-PHDSS_2x05_P2.00mm_Vertical; MPN B10B-PHDSS
J13: Conn_01x02; JST_PH_S2B-PH-K_1x02_P2.00mm_Horizontal; MPN S2B-PH-K-S
J14, J16, J17, J18: USB_B_Micro; USB_Micro-B_Molex_47346-0001; MPN 0473461001
JP2: Jumper_3_Open; SolderJumper-3_P1.3mm_Open_RoundedPad1.0x1.5mm_NumberLabels
JP3, JP4: SolderJumper_2_Open; SolderJumper-2_P1.3mm_Open_RoundedPad1.0x1.5mm
R35, R36: 0; R_0402_1005Metric; MPN RC0603JR-070RL
R37, R38, R39, R40, R41, R42, R43, R44: 10; R_0402_1005Metric; MPN RMCF0603FT10R0
R46, R47, R50, R51: 22; R_0402_1005Metric; MPN RC0603FR-0722RL
R48, R49, R52, R53: 560; R_0402_1005Metric; MPN RMCF0603FT560R
U16, U17: CH330N; SOIC-8_3.9x4.9mm_P1.27mm; MPN CH330N

Connections:
+3.3V: J12.7, J12.8, J15.7, J15.8, JP2.3 (B); also elsewhere on the board
+5V: FB3.2, FB4.2, FB5.2, FB6.2; also elsewhere on the board
FCU_GPIO_A: R39.1; also elsewhere on the board
FCU_GPIO_B: R40.1; also elsewhere on the board
FCU_GPIO_C: R41.1; also elsewhere on the board
FCU_GPIO_D: R42.1; also elsewhere on the board
FCU_GPIO_E: R43.1; also elsewhere on the board
FCU_GPIO_F: R44.1; also elsewhere on the board
FCU_I2C1_SCL: R36.1; also elsewhere on the board
FCU_I2C1_SDA: R35.1; also elsewhere on the board
FCU_NRST: J12.1; also elsewhere on the board
FCU_SWCLK: J12.6; also elsewhere on the board
FCU_SWDIO: J12.2; also elsewhere on the board
FCU_UART1_RX: R37.1; also elsewhere on the board
FCU_UART1_TX: R38.1; also elsewhere on the board
FCU_UART2_RX: U16.6 (TXD); also elsewhere on the board
FCU_UART2_TX: U16.7 (RXD); also elsewhere on the board
FCU_USB_OTG_FS_ID: R48.2; also elsewhere on the board
FCU_USB_OTG_FS_VBUS: JP3.2 (B); also elsewhere on the board
GND: C60.2, C61.2, C62.2, C63.2, J12.3, J12.4, J13.2, J14.5 (GND), J14.6 (Shield), J15.3, J15.4, J16.5 (GND), J16.6 (Shield), J17.5 (GND), J17.6 (Shield), J18.5 (GND), J18.6 (Shield), R49.2, R53.2, U16.3 (GND), U17.3 (GND); also elsewhere on the board
GPS_BACKUP_BAT: JP2.2 (C); also elsewhere on the board
NU_GPIO_A: R39.2; also elsewhere on the board
NU_GPIO_B: R40.2; also elsewhere on the board
NU_GPIO_C: R41.2; also elsewhere on the board
NU_GPIO_D: R42.2; also elsewhere on the board
NU_GPIO_E: R43.2; also elsewhere on the board
NU_GPIO_F: R44.2; also elsewhere on the board
NU_I2C1_SCL: R36.2; also elsewhere on the board
NU_I2C1_SDA: R35.2; also elsewhere on the board
NU_NRST: J15.1; also elsewhere on the board
NU_SWCLK: J15.6; also elsewhere on the board
NU_SWDIO: J15.2; also elsewhere on the board
NU_UART1_RX: R38.2; also elsewhere on the board
NU_UART1_TX: R37.2; also elsewhere on the board
NU_UART2_RX: U17.6 (TXD); also elsewhere on the board
NU_UART2_TX: U17.7 (RXD); also elsewhere on the board
NU_USB_OTG_FS_D+: R50.2; also elsewhere on the board
NU_USB_OTG_FS_D-: R51.2; also elsewhere on the board
NU_USB_OTG_FS_ID: R52.2; also elsewhere on the board
NU_USB_OTG_FS_VBUS: JP4.2 (B); also elsewhere on the board
unnamed: C61.1, D12.2 (A), D14.2 (A), J14.1 (VBUS), U16.5 (VCC)
unnamed: D12.1 (K), FB3.1
unnamed: D13.2 (A), J16.1 (VBUS), JP3.1 (A)
unnamed: D13.1 (K), FB4.1
unnamed: D14.1 (K), R49.1
unnamed: C63.1, D15.2 (A), D17.2 (A), J17.1 (VBUS), U17.5 (VCC)
unnamed: D15.1 (K), FB5.1
unnamed: D16.2 (A), J18.1 (VBUS), JP4.1 (A)
unnamed: D16.1 (K), FB6.1
unnamed: D17.1 (K), R53.1
unnamed: J13.1, JP2.1 (A)
unnamed: J14.3 (D+), U16.1 (UD+)
unnamed: J14.2 (D-), U16.2 (UD-)
unnamed: J16.3 (D+), R46.1
unnamed: J16.2 (D-), R47.1
unnamed: J16.4 (ID), R48.1
unnamed: J17.3 (D+), U17.1 (UD+)
unnamed: J17.2 (D-), U17.2 (UD-)
unnamed: J18.3 (D+), R50.1
unnamed: J18.2 (D-), R51.1
unnamed: J18.4 (ID), R52.1
unnamed: C60.1, U16.8 (V3)
unnamed: C62.1, U17.8 (V3)

Notes on the sheet:
FCU - NU (GPIOs)
Serial Wire Debug Connectors
Other Connections
DFU Programming USBs
GPS Battery Backup
FCU - NU (I2C)
These connections was based on cheap ST-Link version
Logging Debug USBs
FCU - NU (UART)

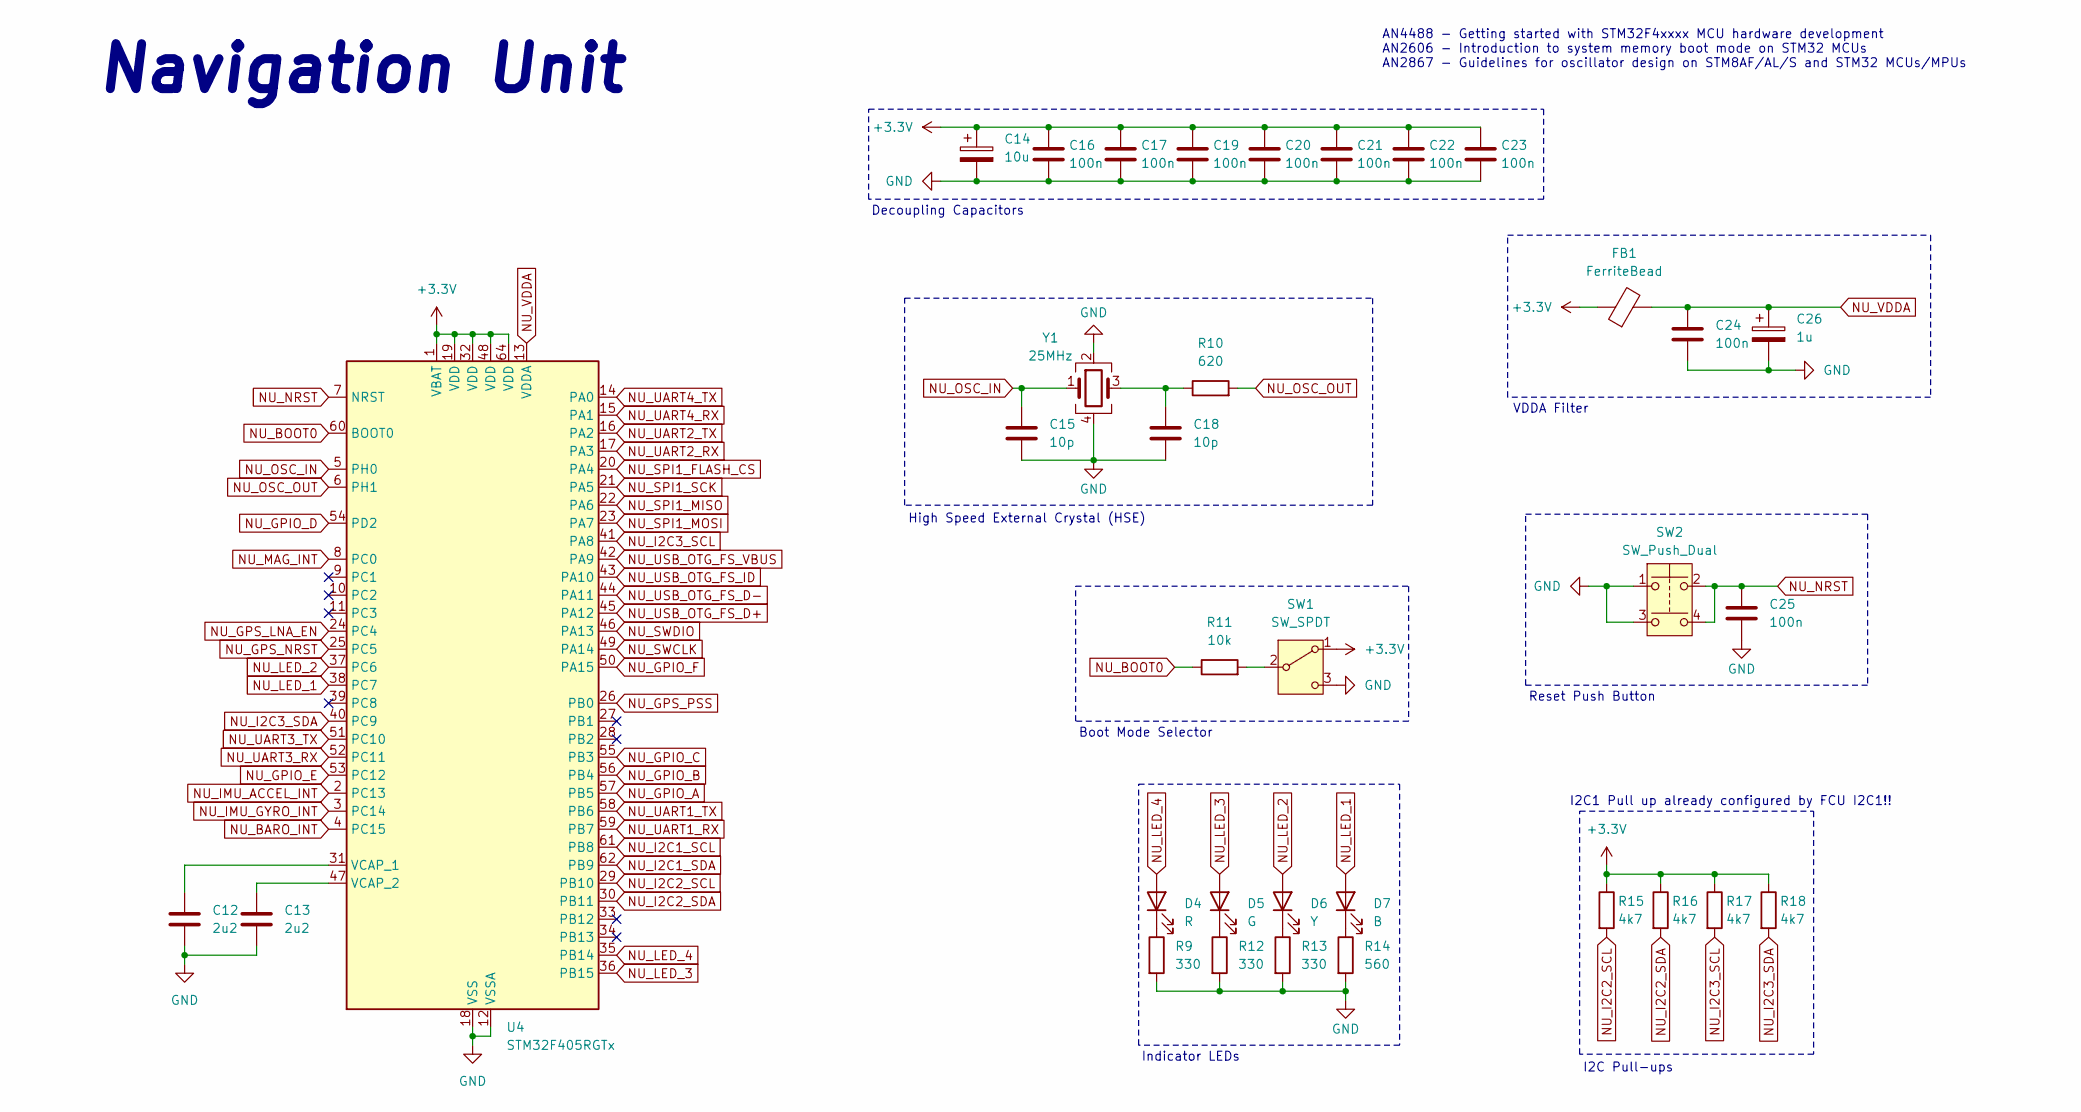
[picture p45: schematic navigation_unit.kicad_sch, Navigation Unit]

Parts:
C12, C13: 2u2; C_0402_1005Metric; MPN CL10B225KP8NNNC
C14: 10u; C_0603_1608Metric; MPN TAJA106K010TNJ
C15, C18: 10p; C_0402_1005Metric; MPN 885012005007
C16, C17, C19, C20, C21, C22, C23, C24: 100n; C_0402_1005Metric; MPN CL05B104KP5NNNC
C25: 100n; C_0402_1005Metric; MPN C0603C104K8RACTU
C26: 1u; CP_EIA-1608-08_AVX-J; MPN T491A105K010AT
D4: R; LED_0402_1005Metric; MPN LTST-C171KRKT
D5: G; LED_0402_1005Metric; MPN LTST-C170GKT
D6: Y; LED_0402_1005Metric; MPN LTST-C171YKT
D7: B; LED_0402_1005Metric; MPN LTST-C171TBKT
FB1: FerriteBead; L_0402_1005Metric; MPN HZ0805E601R-10
R9, R12, R13: 330; R_0402_1005Metric; MPN RC0603JR-07330RL
R10: 620; R_0402_1005Metric; MPN RC0603FR-07620RL
R11: 10k; R_0402_1005Metric; MPN RC0603FR-0710KL
R14: 560; R_0402_1005Metric; MPN RMCF0603FT560R
R15, R16, R17, R18: 4k7; R_0402_1005Metric; MPN ERJ-3EKF4701V
SW1: SW_SPDT; SW_SPDT_PCM12; MPN PCM12SMTR
SW2: SW_Push_Dual; SW4_PTS815 SJM 250 SMTR LFS_CNK; MPN PTS815SJM250SMTRLFS
U4: STM32F405RGTx; LQFP-64_10x10mm_P0.5mm; MPN STM32F405RGT6
Y1: 25MHz; Crystal_SMD_Abracon_ABM8G-4Pin_3.2x2.5mm; MPN ABM8G-25.000MHZ-B4Y-T3

Connections:
+3.3V: C14.1, C16.1, C17.1, C19.1, C20.1, C21.1, C22.1, C23.1, FB1.1, R15.1, R16.1, R17.1, R18.1, SW1.1 (A), U4.1 (VBAT), U4.19 (VDD), U4.32 (VDD), U4.48 (VDD), U4.64 (VDD); also elsewhere on the board
GND: C12.2, C13.2, C14.2, C15.2, C16.2, C17.2, C18.2, C19.2, C20.2, C21.2, C22.2, C23.2, C24.2, C25.2, C26.2, R9.2, R12.2, R13.2, R14.2, SW1.3 (C), SW2.1, SW2.3, U4.12 (VSSA), U4.18 (VSS), U4.63 (VSS), Y1.2, Y1.4; also elsewhere on the board
NU_BARO_INT: U4.4 (PC15); also elsewhere on the board
NU_BOOT0: R11.1, U4.60 (BOOT0)
NU_GPIO_A: U4.57 (PB5); also elsewhere on the board
NU_GPIO_B: U4.56 (PB4); also elsewhere on the board
NU_GPIO_C: U4.55 (PB3); also elsewhere on the board
NU_GPIO_D: U4.54 (PD2); also elsewhere on the board
NU_GPIO_E: U4.53 (PC12); also elsewhere on the board
NU_GPIO_F: U4.50 (PA15); also elsewhere on the board
NU_GPS_LNA_EN: U4.24 (PC4); also elsewhere on the board
NU_GPS_NRST: U4.25 (PC5); also elsewhere on the board
NU_GPS_PSS: U4.26 (PB0); also elsewhere on the board
NU_I2C1_SCL: U4.61 (PB8); also elsewhere on the board
NU_I2C1_SDA: U4.62 (PB9); also elsewhere on the board
NU_I2C2_SCL: R15.2, U4.29 (PB10); also elsewhere on the board
NU_I2C2_SDA: R16.2, U4.30 (PB11); also elsewhere on the board
NU_I2C3_SCL: R17.2, U4.41 (PA8); also elsewhere on the board
NU_I2C3_SDA: R18.2, U4.40 (PC9); also elsewhere on the board
NU_IMU_ACCEL_INT: U4.2 (PC13); also elsewhere on the board
NU_IMU_GYRO_INT: U4.3 (PC14); also elsewhere on the board
NU_LED_1: D7.2 (A), U4.38 (PC7)
NU_LED_2: D6.2 (A), U4.37 (PC6)
NU_LED_3: D5.2 (A), U4.36 (PB15)
NU_LED_4: D4.2 (A), U4.35 (PB14)
NU_MAG_INT: U4.8 (PC0); also elsewhere on the board
NU_NRST: C25.1, SW2.2, SW2.4, U4.7 (NRST); also elsewhere on the board
NU_OSC_IN: C15.1, U4.5 (PH0), Y1.1
NU_OSC_OUT: R10.2, U4.6 (PH1)
NU_SPI1_FLASH_CS: U4.20 (PA4); also elsewhere on the board
NU_SPI1_MISO: U4.22 (PA6); also elsewhere on the board
NU_SPI1_MOSI: U4.23 (PA7); also elsewhere on the board
NU_SPI1_SCK: U4.21 (PA5); also elsewhere on the board
NU_SWCLK: U4.49 (PA14); also elsewhere on the board
NU_SWDIO: U4.46 (PA13); also elsewhere on the board
NU_UART1_RX: U4.59 (PB7); also elsewhere on the board
NU_UART1_TX: U4.58 (PB6); also elsewhere on the board
NU_UART2_RX: U4.17 (PA3); also elsewhere on the board
NU_UART2_TX: U4.16 (PA2); also elsewhere on the board
NU_UART3_RX: U4.52 (PC11); also elsewhere on the board
NU_UART3_TX: U4.51 (PC10); also elsewhere on the board
NU_UART4_RX: U4.15 (PA1); also elsewhere on the board
NU_UART4_TX: U4.14 (PA0); also elsewhere on the board
NU_USB_OTG_FS_D+: U4.45 (PA12); also elsewhere on the board
NU_USB_OTG_FS_D-: U4.44 (PA11); also elsewhere on the board
NU_USB_OTG_FS_ID: U4.43 (PA10); also elsewhere on the board
NU_USB_OTG_FS_VBUS: U4.42 (PA9); also elsewhere on the board
NU_VDDA: C24.1, C26.1, FB1.2, U4.13 (VDDA)
unnamed: C18.1, R10.1, Y1.3
unnamed: D4.1 (K), R9.1
unnamed: D5.1 (K), R12.1
unnamed: D6.1 (K), R13.1
unnamed: D7.1 (K), R14.1
unnamed: R11.2, SW1.2 (B)
unnamed: C12.1, U4.31 (VCAP_1)
unnamed: C13.1, U4.47 (VCAP_2)

Notes on the sheet:
Decoupling Capacitors
I2C Pull-ups
Indicator LEDs
I2C1 Pull up already configured by FCU I2C1!!
Reset Push Button
Boot Mode Selector
VDDA Filter
AN4488 - Getting started with STM32F4xxxx MCU hardware development AN2606 - Introduction to system memory boot mode on STM32 MCUs AN2867 - Guidelines for oscillator design on STM8AF/AL/S and STM32 MCUs/MPUs
Navigation Unit
High Speed External Crystal (HSE)

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
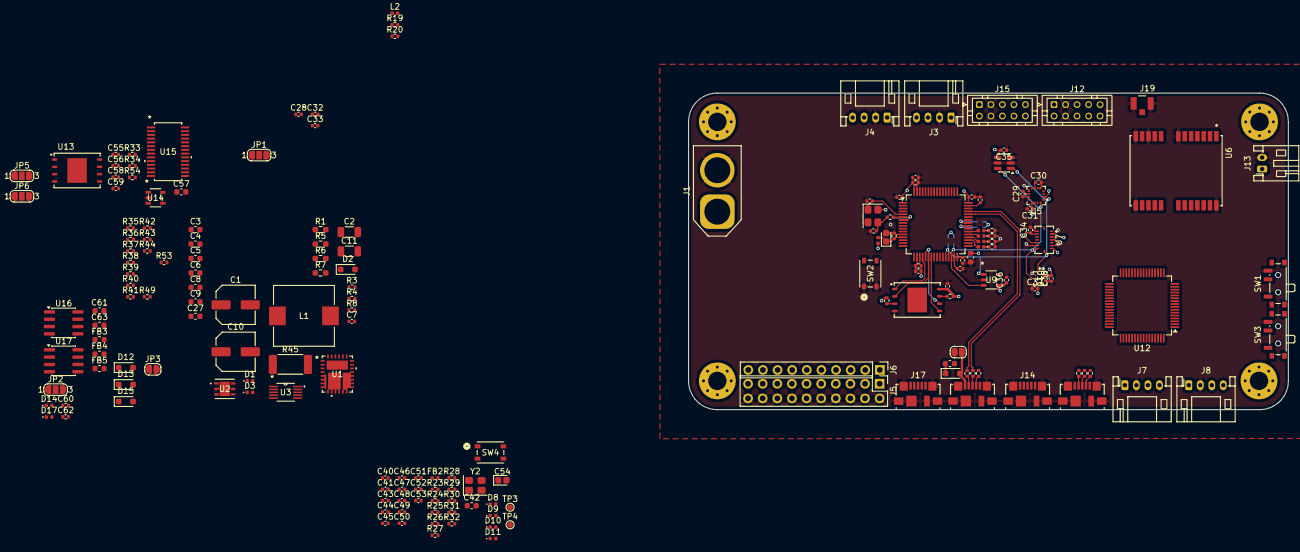
[picture p46: board aircraft.kicad_pcb from above]

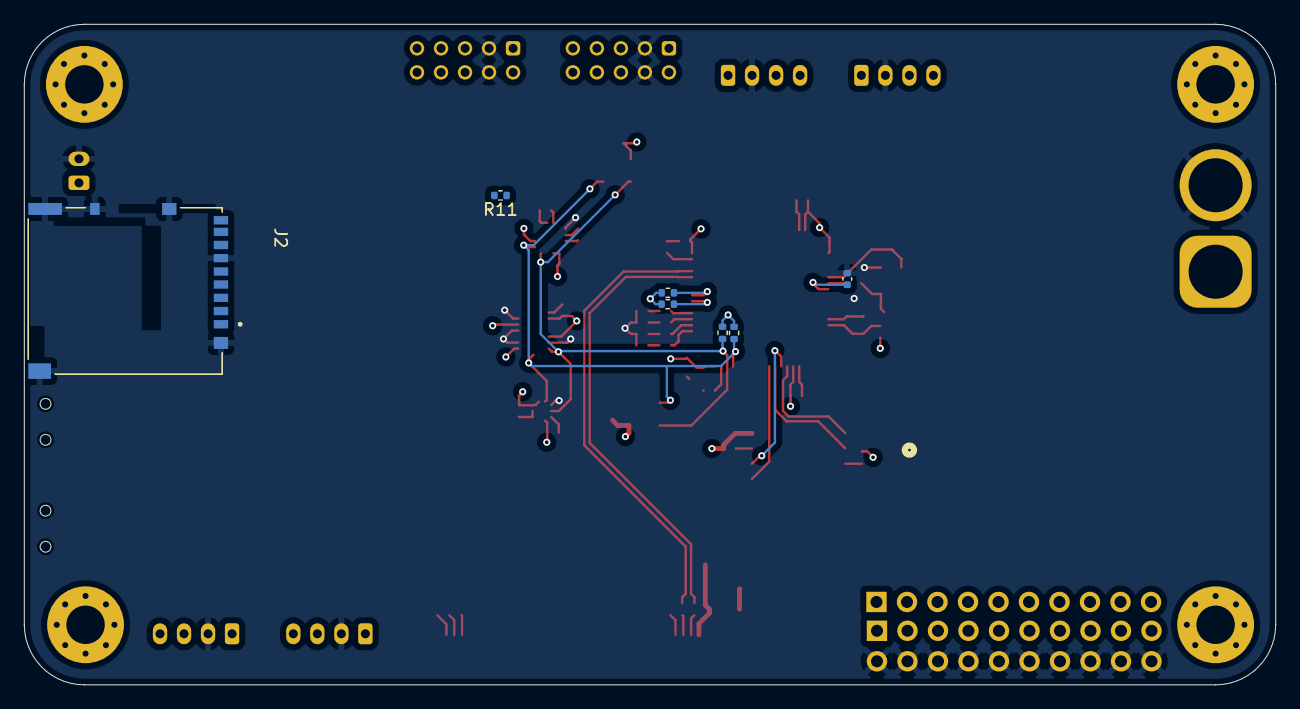
[picture p47: board aircraft.kicad_pcb from below]

Board: 4 copper layers, 104.2 x 55.0 mm, 188 parts (7 on the bottom side), 163 nets.
