brenulevi/GravitumFCS/FlightControlUnit/FlightControlUnit.ioc

Mcu.UserName=STM32F405RGTx
PA0-WKUP.Signal=UART4_TX
PA1.Signal=UART4_RX
PA10.Signal=USB_OTG_FS_ID
PA11.Signal=USB_OTG_FS_DM
PA12.Signal=USB_OTG_FS_DP
PA13.Signal=SYS_JTMS-SWDIO
PA14.Signal=SYS_JTCK-SWCLK
PA15.Signal=S_TIM2_CH1_ETR
PA2.Signal=USART2_TX
PA3.Signal=USART2_RX
PA4.GPIO_Label=FCU_SPI1_CS_FLASH
PA4.Signal=GPIO_Input
PA5.Signal=SPI1_SCK
PA6.Signal=SPI1_MISO
PA7.Signal=SPI1_MOSI
PA9.Signal=USB_OTG_FS_VBUS
PB0.Signal=S_TIM3_CH3
PB1.Signal=S_TIM3_CH4
PB10.Signal=I2C2_SCL
PB11.Signal=I2C2_SDA
PB12.GPIO_Label=FCU_LED_4
PB12.Signal=GPIO_Output
PB13.GPIO_Label=FCU_LED_3
PB13.Signal=GPIO_Output
PB14.GPIO_Label=FCU_LED_2
PB14.Signal=GPIO_Output
PB15.GPIO_Label=FCU_LED_1
PB15.Signal=GPIO_Output
PB3.Signal=S_TIM2_CH2
PB6.Signal=USART1_TX
PB7.Signal=USART1_RX
PB8.Signal=I2C1_SCL
PB9.Signal=I2C1_SDA
PC0.GPIO_Label=FCU_GPIO_D
PC0.Signal=GPIO_Input
PC1.GPIO_Label=FCU_GPIO_C
PC1.Signal=GPIO_Output
PC10.Signal=USART3_TX
PC11.Signal=USART3_RX
PC12.Signal=SDIO_CK
PC14-OSC32_IN.GPIO_Label=FCU_GPIO_F
PC14-OSC32_IN.Signal=GPIO_Input
PC15-OSC32_OUT.GPIO_Label=FCU_GPIO_E
PC15-OSC32_OUT.Signal=GPIO_Output
PC2.GPIO_Label=FCU_GPIO_B
PC2.Signal=GPIO_Input
PC3.GPIO_Label=FCU_GPIO_A
PC3.Signal=GPIO_Output
PC6.Signal=S_TIM3_CH1
PC7.Signal=S_TIM3_CH2
PC8.Signal=SDIO_D0
PC9.GPIO_Label=FCU_SDIO_DET
PC9.Signal=GPIO_Input
PD2.Signal=SDIO_CMD
PH0-OSC_IN.Signal=RCC_OSC_IN
PH1-OSC_OUT.Signal=RCC_OSC_OUT
