brenulevi/GravitumFCS/(commit log)

2026-01-15 better folder structure, fcu schematic done, fcu peripherals done, fcu and nu stm32 projects
    [10LGA_2X2X0p75_BOS.step, BMI088.step, DGS0010A.stp, IST8310.step, MIC26903YJL-TR.step, NEO-M8N-0.STEP, SON_DFN6_3X3_STM.step, SOT-23-5_2P9X1P6_MCH.step]
2026-01-15 fcu, nu schematics, problem with pins
    [5-1814832-1.step, DBV0006A.stp, flight_control_peripherals.kicad_sch, flight_control_unit.kicad_sch, navigation_peripherals.kicad_sch, navigation_unit.kicad_sch, other_connections.kicad_sch, power_supply.kicad_sch]
2026-01-16 pin mess up win, starting over again
    [flight_control_unit.kicad_sch, navigation_peripherals.kicad_sch, navigation_unit.kicad_sch, other_connections.kicad_sch]
2026-01-16 added projects, schematic almost done, need revision
    [flight_control_peripherals.kicad_sch, flight_control_unit.kicad_sch, navigation_peripherals.kicad_sch, navigation_unit.kicad_sch, other_connections.kicad_sch]
2026-01-16 sd card receptacle 10u capacitor
    [flight_control_peripherals.kicad_sch]
2026-01-17 version 0.1.0
    [aircraft.kicad_sch, flight_control_peripherals.kicad_sch, flight_control_unit.kicad_sch, navigation_peripherals.kicad_sch, navigation_unit.kicad_sch, other_connections.kicad_sch, power_supply.kicad_sch]
2026-01-17 version 0.1.1, added dfu usb to firmware upload, changed pwm channels
    [flight_control_peripherals.kicad_sch, flight_control_unit.kicad_sch, navigation_unit.kicad_sch, other_connections.kicad_sch, power_supply.kicad_sch]
2026-01-17 i forgot to change the damn label
    [aircraft.kicad_sch]
2026-01-18 added nu i2c test point, some documentation hehe
    [flight_control_unit.kicad_sch, navigation_unit.kicad_sch, other_connections.kicad_sch]
2026-01-22 firmware started, freertos, initial sensors abstractions, some pin layout changes
    [flight_control_peripherals.kicad_sch, navigation_peripherals.kicad_sch, power_supply.kicad_sch]
2026-01-22 pin refatoration, freertos code
    [flight_control_unit.kicad_sch, navigation_unit.kicad_sch]
2026-01-23 add some footprints, and pcb configs
    [aircraft.kicad_pcb, flight_control_peripherals.kicad_sch, flight_control_unit.kicad_sch, navigation_peripherals.kicad_sch, navigation_unit.kicad_sch, other_connections.kicad_sch, power_supply.kicad_sch]
2026-01-26 hardware: reorganizing components, im fucked
    [aircraft.kicad_pcb, flight_control_peripherals.kicad_sch, flight_control_unit.kicad_sch, navigation_peripherals.kicad_sch, navigation_unit.kicad_sch, other_connections.kicad_sch, power_supply.kicad_sch]
2026-01-27 hardware: initial power supply layout
    [IND_SRP1038A_BRN.step, aircraft.kicad_pcb, flight_control_peripherals.kicad_sch, power_supply.kicad_sch]
2026-01-28 sensors positioned
    [aircraft.kicad_pcb, flight_control_peripherals.kicad_sch, navigation_peripherals.kicad_sch]
2026-01-29 usb traces, i2c, spi, sdio, and more
    [aircraft.kicad_pcb, flight_control_peripherals.kicad_sch, navigation_unit.kicad_sch, other_connections.kicad_sch]
2026-01-29 i2c sensors traces
    [aircraft.kicad_pcb, navigation_unit.kicad_sch]
2026-01-30 idk what i did here
    [aircraft.kicad_pcb]
2026-01-30 starting layout again...
    [aircraft.kicad_pcb]
2026-02-11 schematic and BOM done
    [ABM8G-25.000MHZ-18-D2Y-T.step, AT45DB641E-SHN2B-T.step, B10B-PHDSS--3DModel-STEP-56544.STEP, B340A-13-F.STEP, LD39200PU33R.step, LGA-12_2X2X0P7_STM.step, MIC26903YJL-TR.step, MPRLS0025PA00001A.step]
